MichaelSchmidl/Project5/hardware/CAD/BOM.xls

Part Name/Number | Description | Qty. | Comps. | Digikey | Netto | Summe
100K-1-0603 | Widerstand 100K 1% 0603 | 1 | R9 | 311-100KHRCT-ND | 0.08 | 0.10
100NF/50-X7R-0603 | Keramikkondensator 100nF/50V 0 | 9 | C1, C4-8, C10, C13, C15 | 1276-CL10B104KB8NNNLCT-ND | 0.08 | 0.86
100R-1-0603 | Widerstand 100R 1% 0603 | 1 | R2 | A129676CT-ND | 0.08 | 0.10
10NF/50-X7R-0603 | Keramikkondensator 10nF/50V 06 | 1 | C14 | 1276-1009-1-ND | 0.08 | 0.10
10R-1-0603 | Widerstand 10R 1% 0603 | 1 | R1 | YAG3351CT-ND | 0.08 | 0.10
10UF/16-X5R-0805 | Keramikkondensator 10uF/16V 08 | 2 | C2, C12 | 1276-6472-1-ND | 0.23 | 0.55
1UF/16-X5R-0805 | Keramikkondensator 1uF/16V 080 | 2 | C9, C11 | 1276-6471-1-ND | 0.08 | 0.19
22R-1-0603 | Widerstand 22R 1% 0603 | 4 | R11-14 | 311-22.0HRCT-ND | 0.08 | 0.38
2K2-1-0603 | Widerstand 2K2 1% 0603 | 2 | R8, R15 | 311-2.20KHRCT-ND | 0.08 | 0.19
74HC20-SO14 | 2 fach NAND mit 4 Eingängen | 1 | IC2 | 296-8263-1-ND | 0.27 | 0.32 | bestellen
AT42QT1011-SOT23-6 | Kapazitive Taste, single-key Q | 1 | IC3 | nicht vorrätig |  | 0
BCR108-SOT23 | NPN Digitaltransistor 50V/100 | 1 | T2 | BCR108E6327HTSA1CT-ND | 0.16 | 0.19
BLM21A-102S-0805 | Murata EMI Supression Filter ( | 1 | L1 | 490-1041-1-ND | 0.13 | 0.15
BLUETOOTH RSL10SIP | Bluetooth-Modul mit Antenne, 1 | 1 | A1 | NCH-RSL10-101S51-ACGOSCT-ND | 8.56 | 10.19
DMP2123L-SOT23 | P-Kanal MOSFET 20V/3A/72mR | 1 | T1 | DMP2123LDICT-ND | 0.35 | 0.42
IN-S124BRR LED R | Led rot, 1206, bottom view, 90 | 35 | H11-57 | 1830-1128-1-ND | 0.23 | 9.37 | bestellen
KP3216 LED 1206 OR | SMD-LED 1206 orange | 4 | H3-6 | 754-1140-1-ND | 0.26 | 1.24 | bestellen
MMA8652-DFN10 | Beschleunigungssensor, 3 Achse | 1 | B1 | vorhanden | 0.00 | 0.00
PCF8574-SO16 | I2C-Bus I/O-Expander | 1 | IC4 | 568-1076-5-ND | 1.07 | 1.27
REEDKONTAKT RI02-SMDM | Reedkontakt SMD 11,5x2,3mm | 1 | S1 | 1835-RI-02SMDM-1520-G1CT-ND | 0.55 | 0.65 | bestellen
TLC5955-QFN56 | 48 Kanal LED Treiber mit int P | 1 | IC1 | 296-40588-1-ND | 4.94 | 5.88
TSOP98636 LIEGEND | IR-Empfänger, 36kHz DeMod, RC5 | 1 | H1 | TSOP98636-ND | 0.85 | 1.01 | bestellen
_LEITERPLATTE-DEFAULT | Leiterplatte | 1 | LP1 | JLCPCB 61x53mm inkl. Versand |  | 7.68 | bestellen
Summe |  |  |  |  |  | 40.83
