MichaelSchmidl/Project5/hardware/CAD/EASTEREGG_100.stp

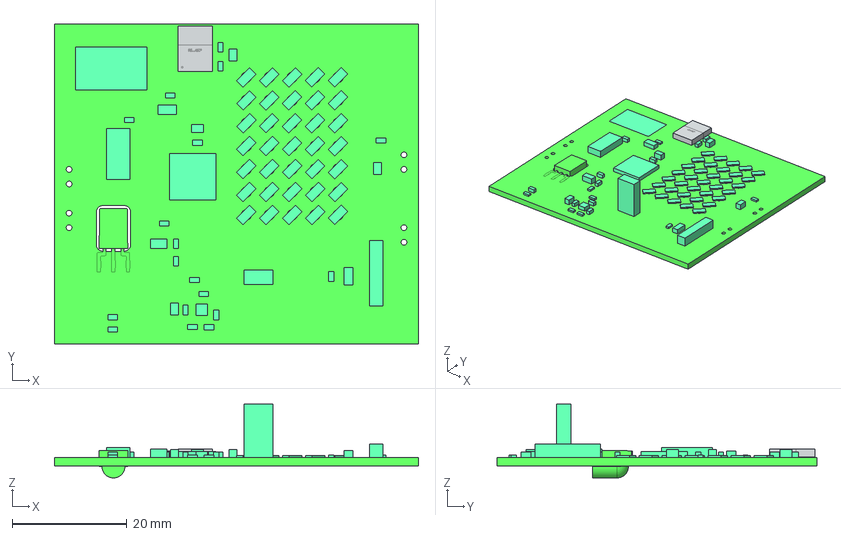
[picture p7: CAD file, 2021-01-31]
hardware/CAD/EASTEREGG_100.stp
63.5 x 55.9 x 12.9 mm
