MichaelSchmidl/Project5/hardware/CAD/Olli.stp

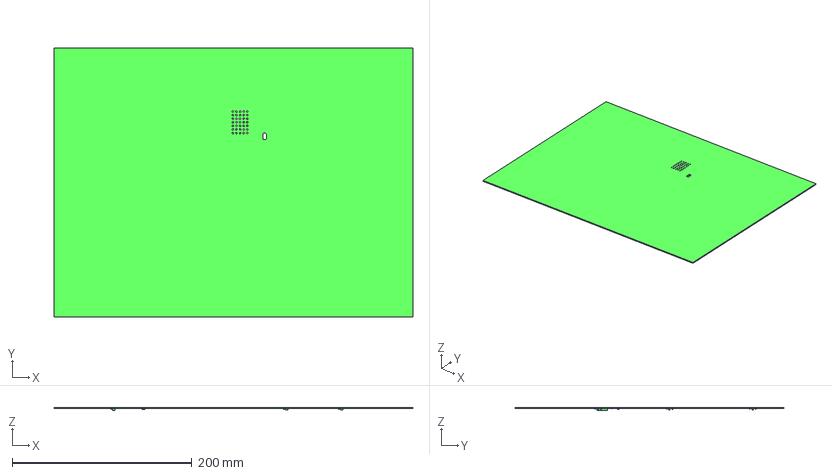
[picture p8: CAD file, 2021-01-31]
hardware/CAD/Olli.stp
400.0 x 300.0 x 3.80 mm
