MichaelSchmidl/Project5/hardware/CAD/EASTEREGG_SP_200.pdf

# Debug

# 5x7 LED Matrix

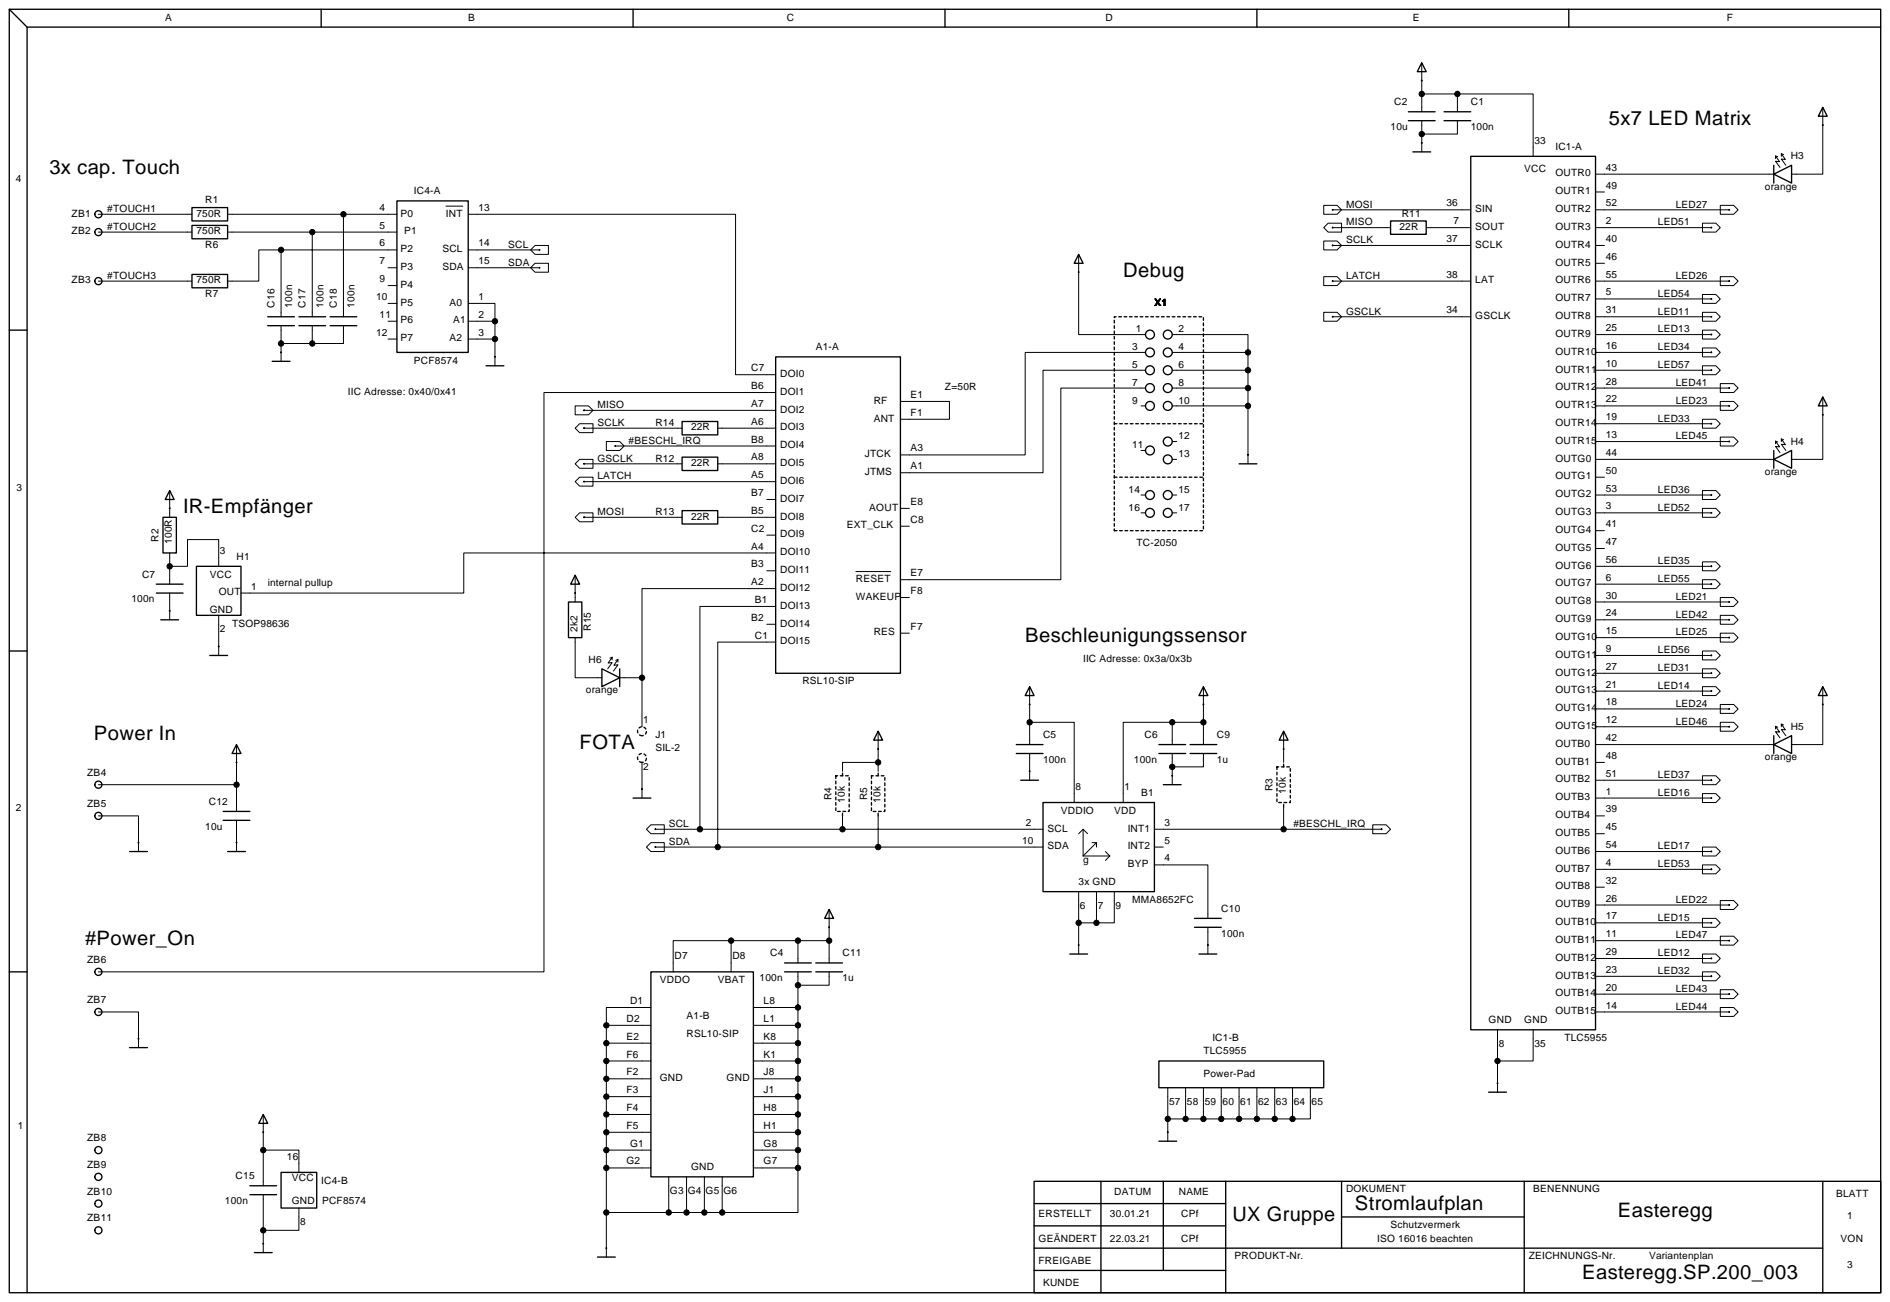
[picture p9: page 1]

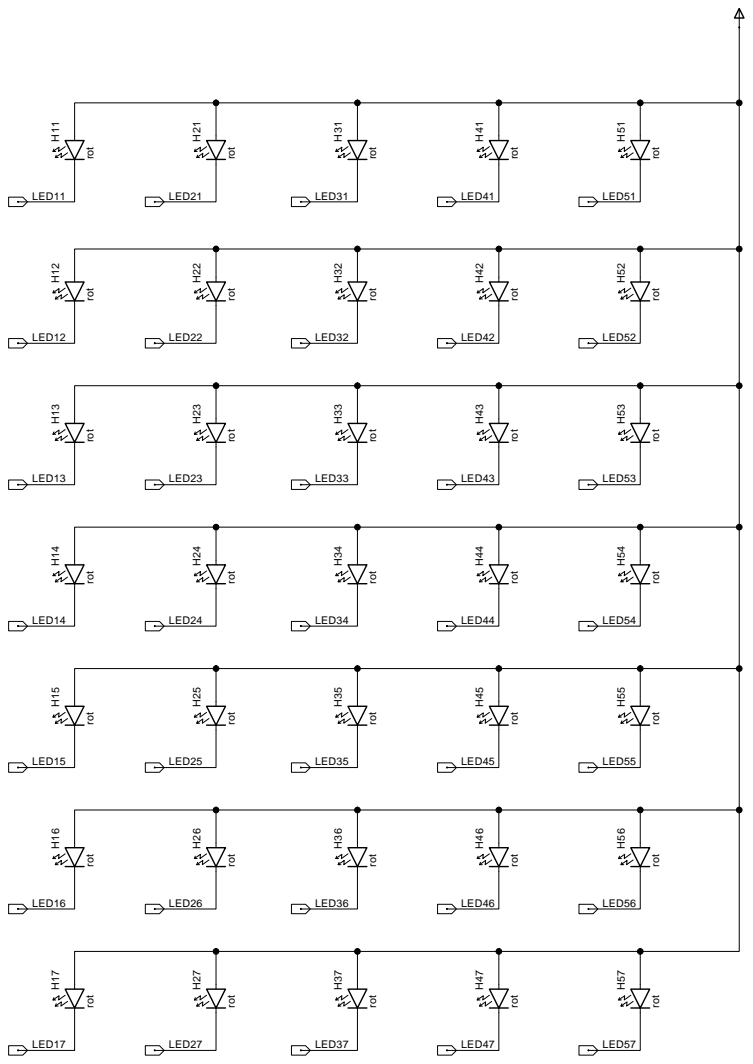
[picture p10: page 2]

# ÄNDERUNGS-HISTORIE

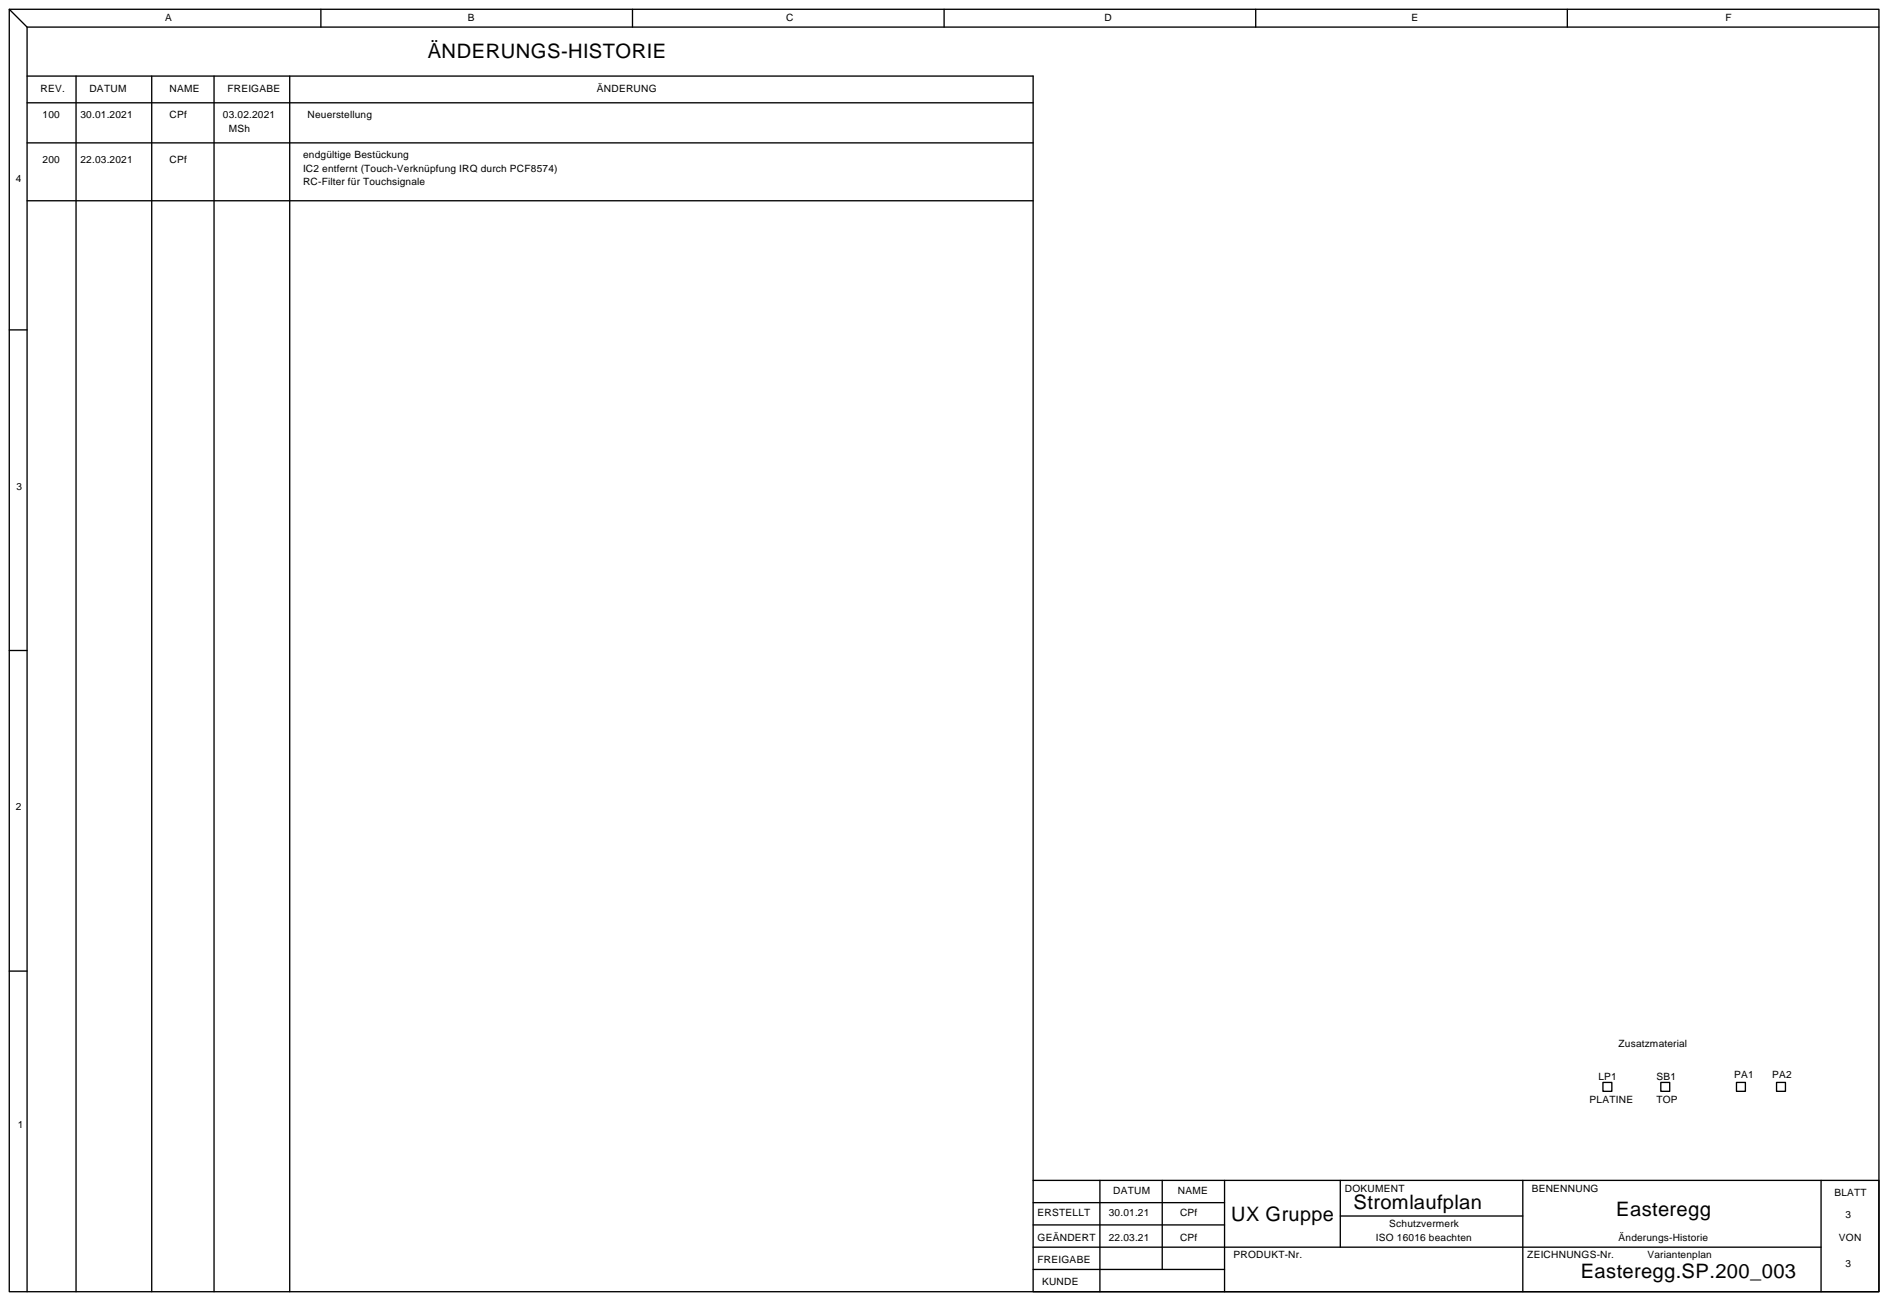
[picture p11: page 3]
BLATT; BENENNUNG; ERSTELLT; DATUM; NAME; DOKUMENT; UX Gruppe; Schutzvermerk; PLATINE; TOP; CPf; Stromlaufplan; Zusatzmaterial; FREIGABE; ÄNDERUNG; Änderungs-Historie; REV.; 03.02.2021 MSh; Easteregg; Neuerstellung

endgültige Bestückung
IC2 entfernt (Touch-Verknüpfung IRQ durch PCF8574)
RC-Filter für Touchsignale
