MichaelSchmidl/Project5/hardware/CAD/Olli_SP.pdf

# #Power_On

# Eingang von Batteriehalter

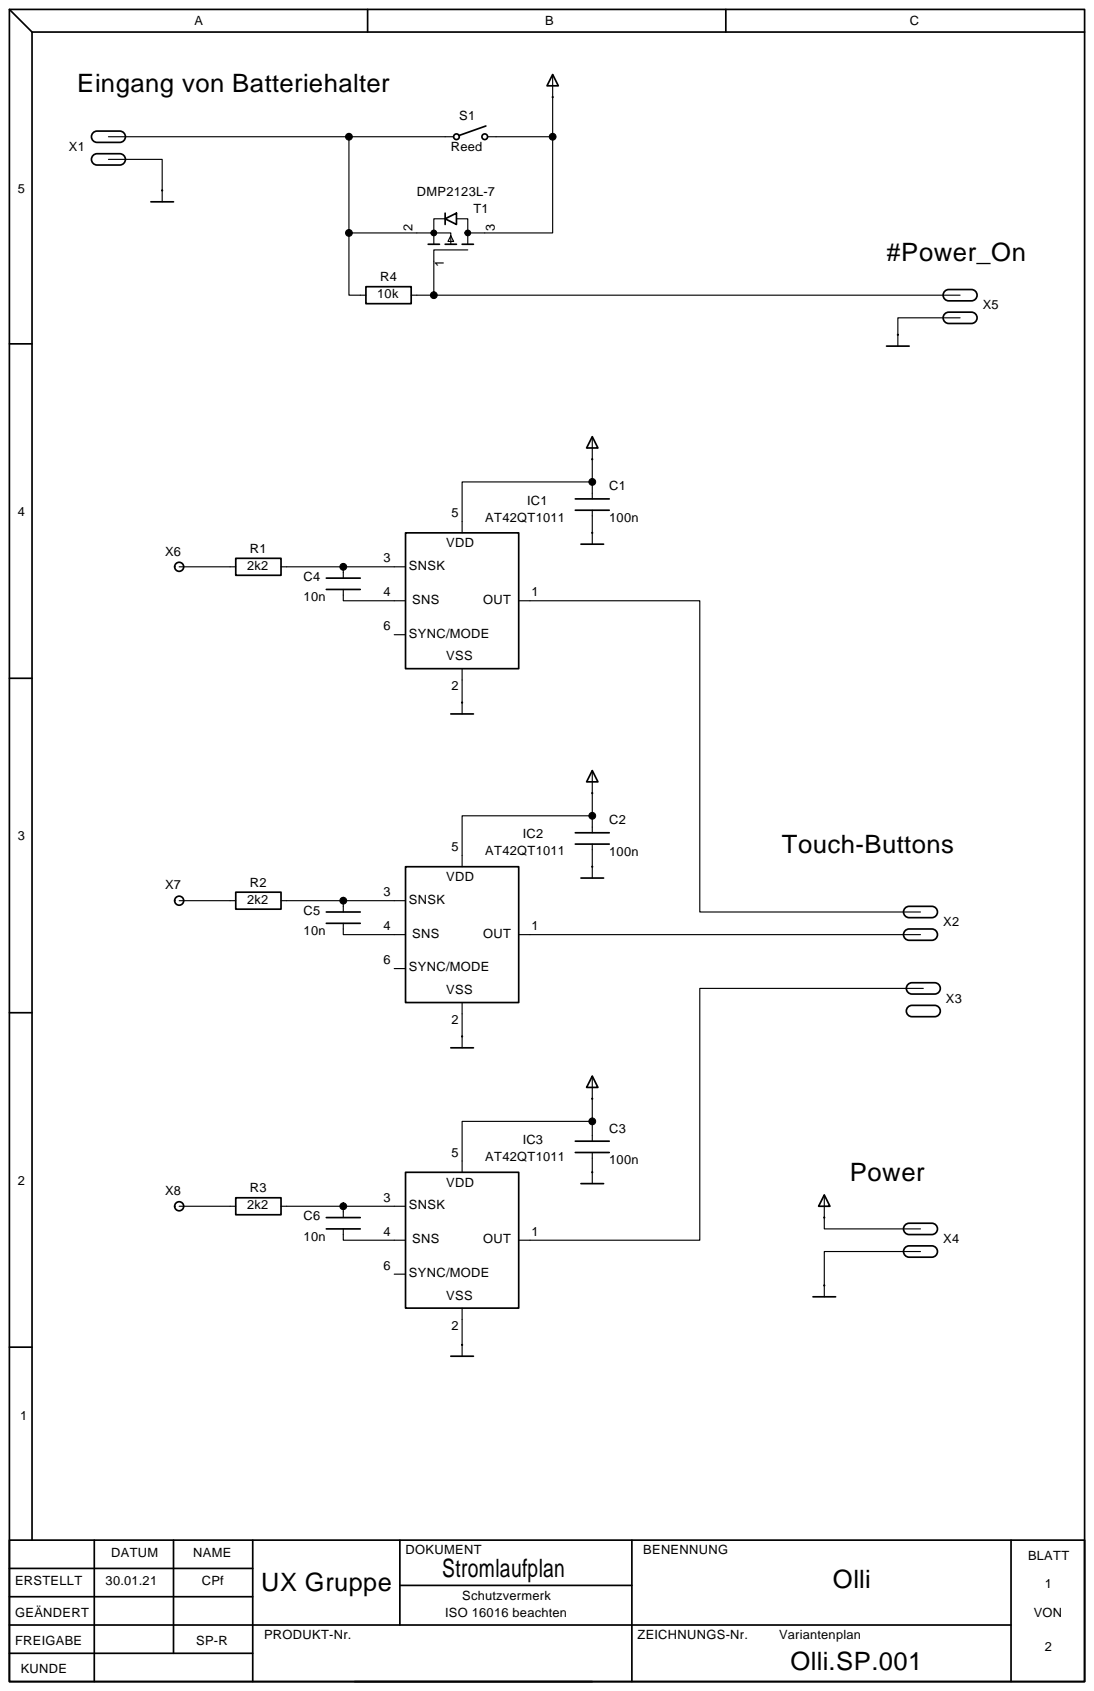
[picture p12: page 1]

# ÄNDERUNGS-HISTORIE

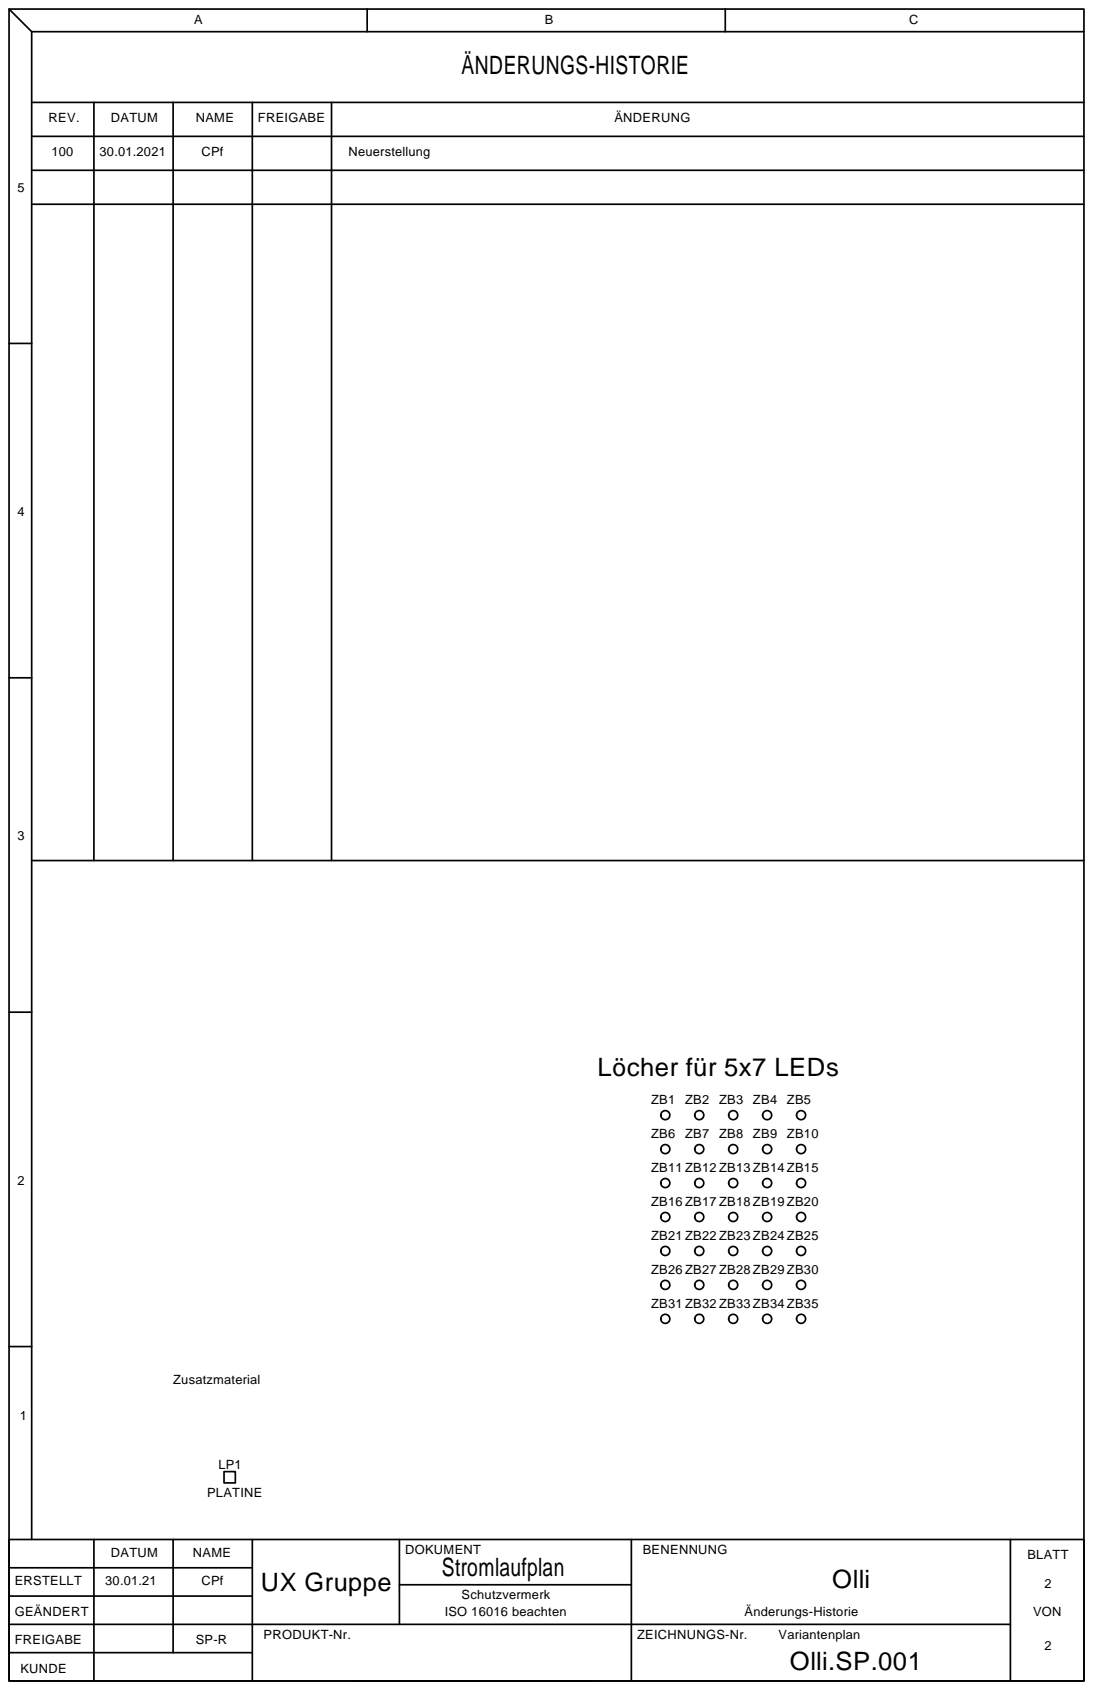
[picture p13: page 2]
VON; PRODUKT-Nr.; ZEICHNUNGS-Nr.; BLATT BENENNUNG; ISO 16016 beachten; ERSTELLT; FREIGABE; GEÄNDERT; KUNDE; DATUM; NAME; DOKUMENT; UX Gruppe; Schutzvermerk; PLATINE; ÄNDERUNG; Änderungs-Historie; REV.; Stromlaufplan; Neuerstellung; Zusatzmaterial; CPf; Olli; Olli.SP.001; Variantenplan

Löcher für 5x7 LEDs
