MichaelSchmidl/Project5/hardware/CAD/EASTEREGG_SP_100.pdf

# just for tuning

# 3x cap. Touch

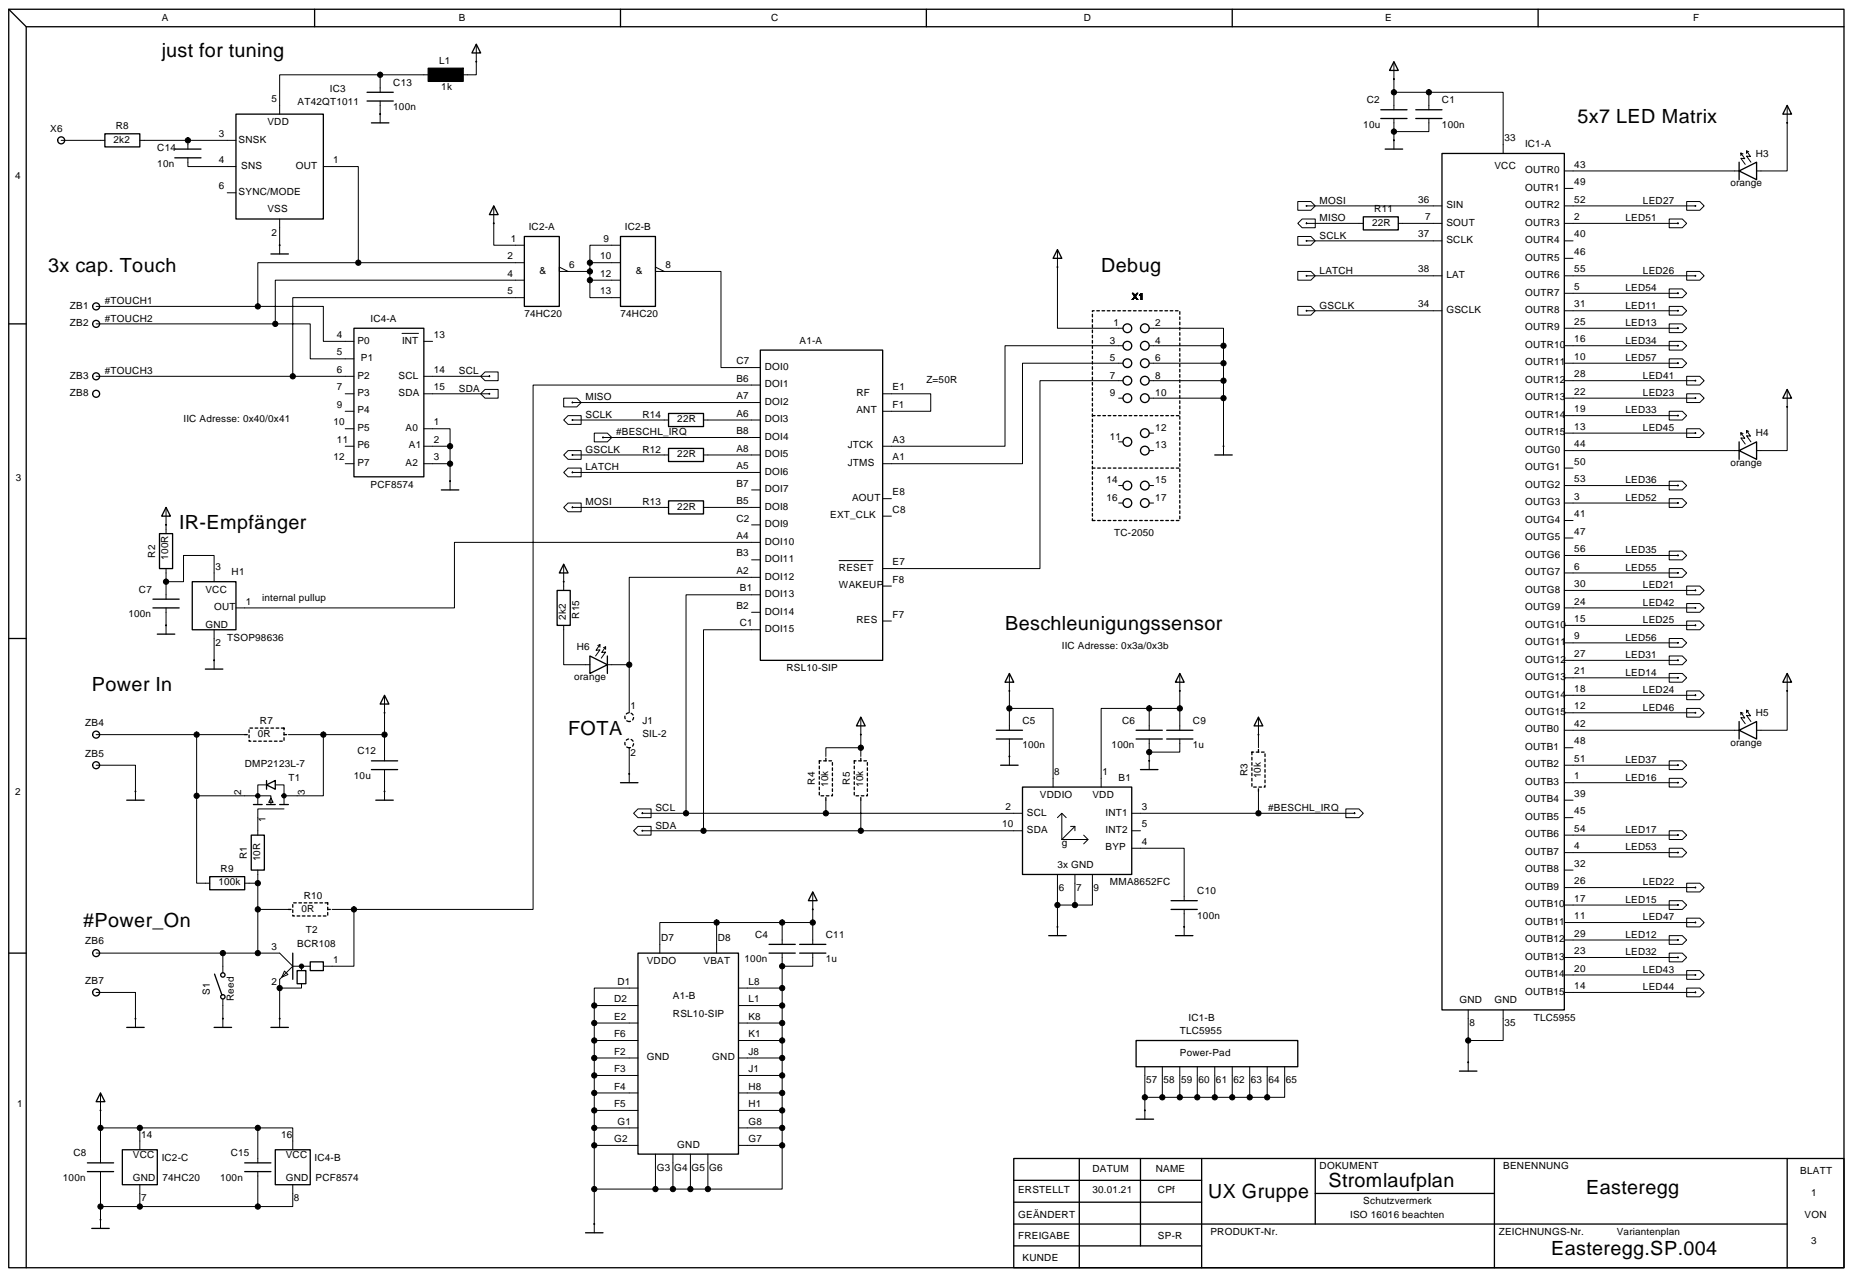
[picture p14: page 1]


# ÄNDERUNGS-HISTORIE

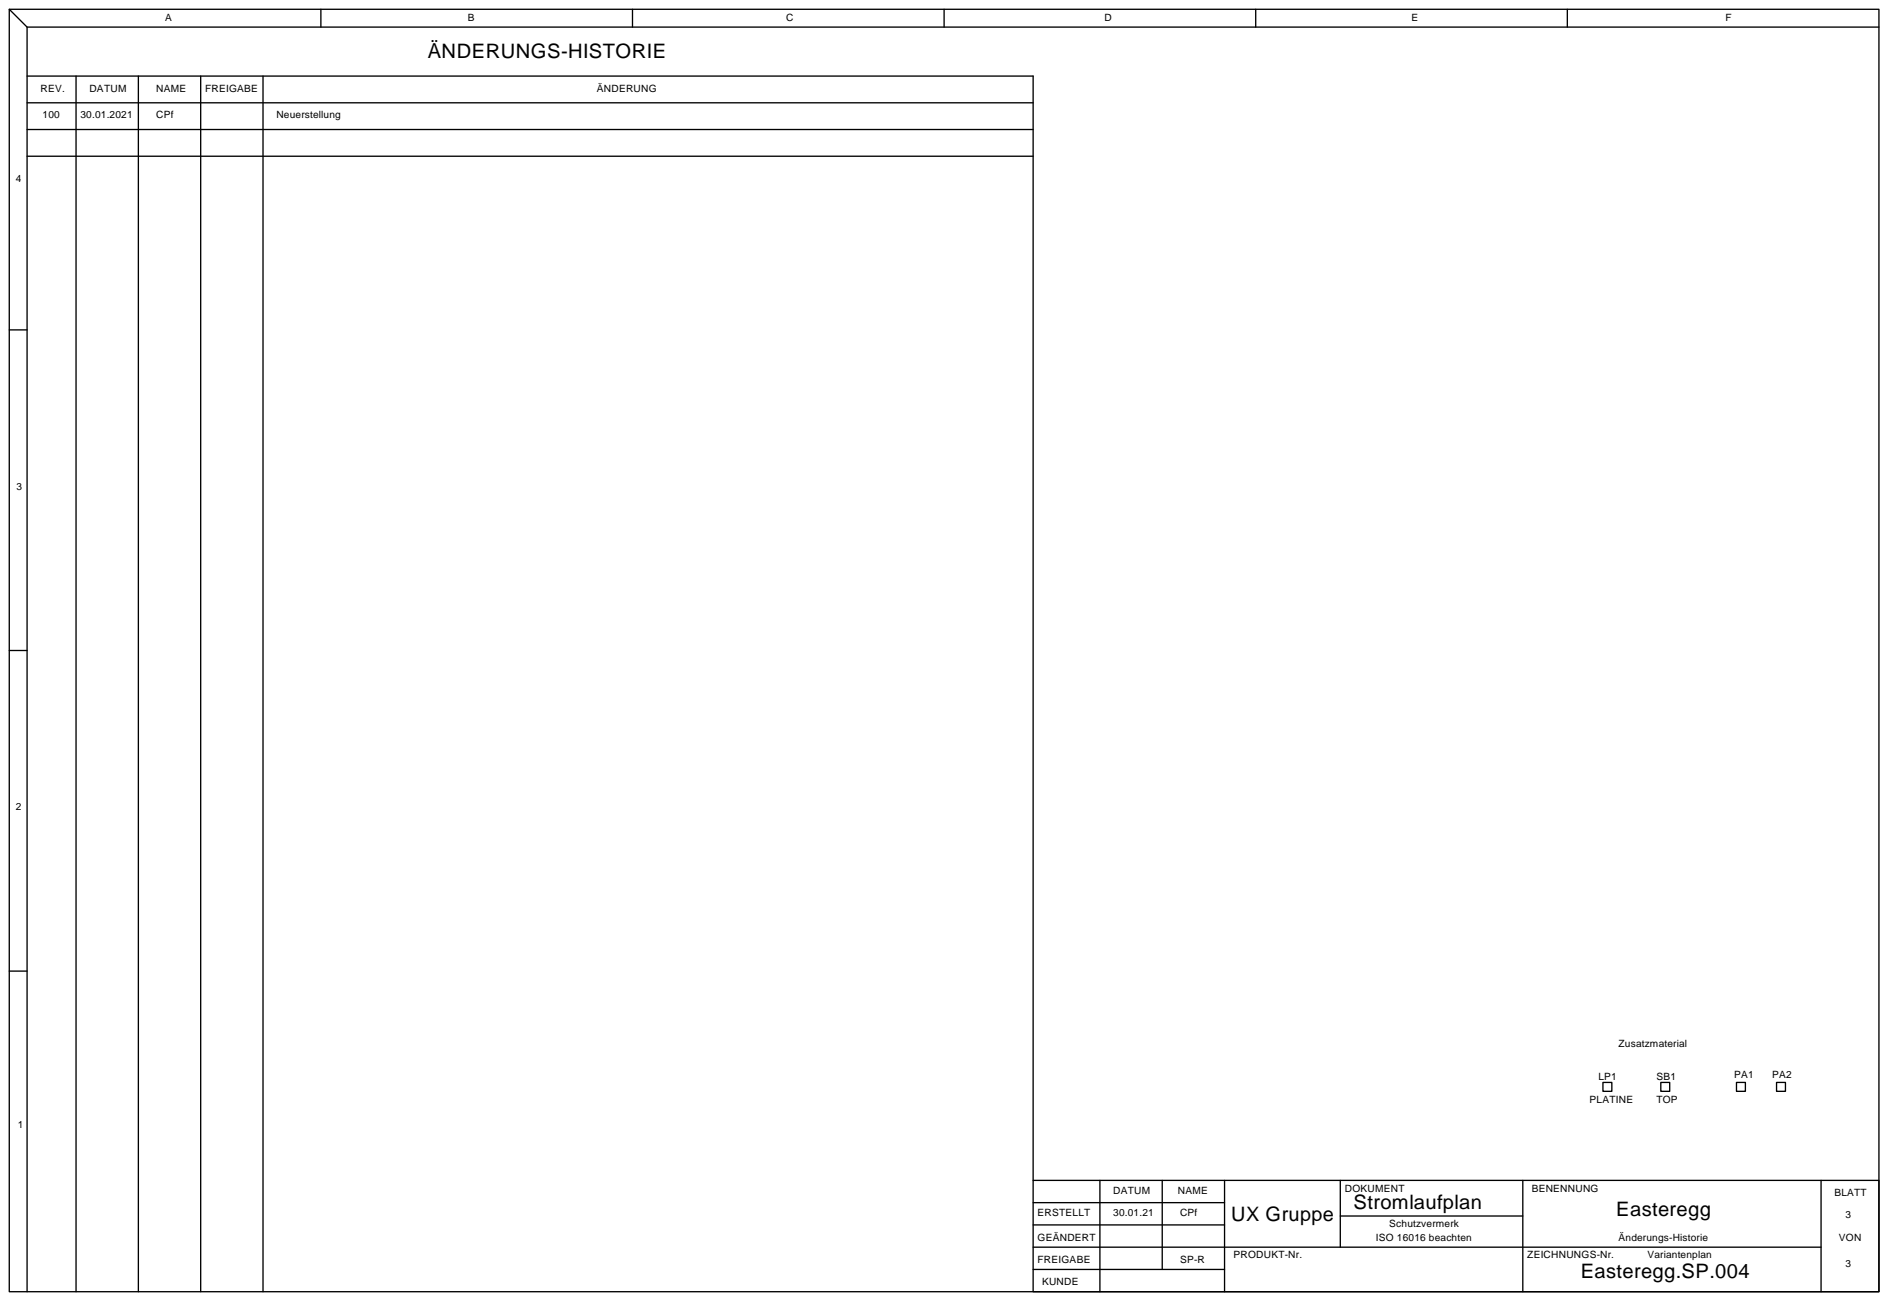
[picture p15: page 3]
BLATT; BENENNUNG; ERSTELLT; DATUM; NAME; DOKUMENT; UX Gruppe; Schutzvermerk; PLATINE; TOP; Neuerstellung; Stromlaufplan; Zusatzmaterial; ÄNDERUNG; Änderungs-Historie; REV.; FREIGABE; CPf; Easteregg
