MichaelSchmidl/Project5/docs/hw/EASTEREGG_BP_100.pdf

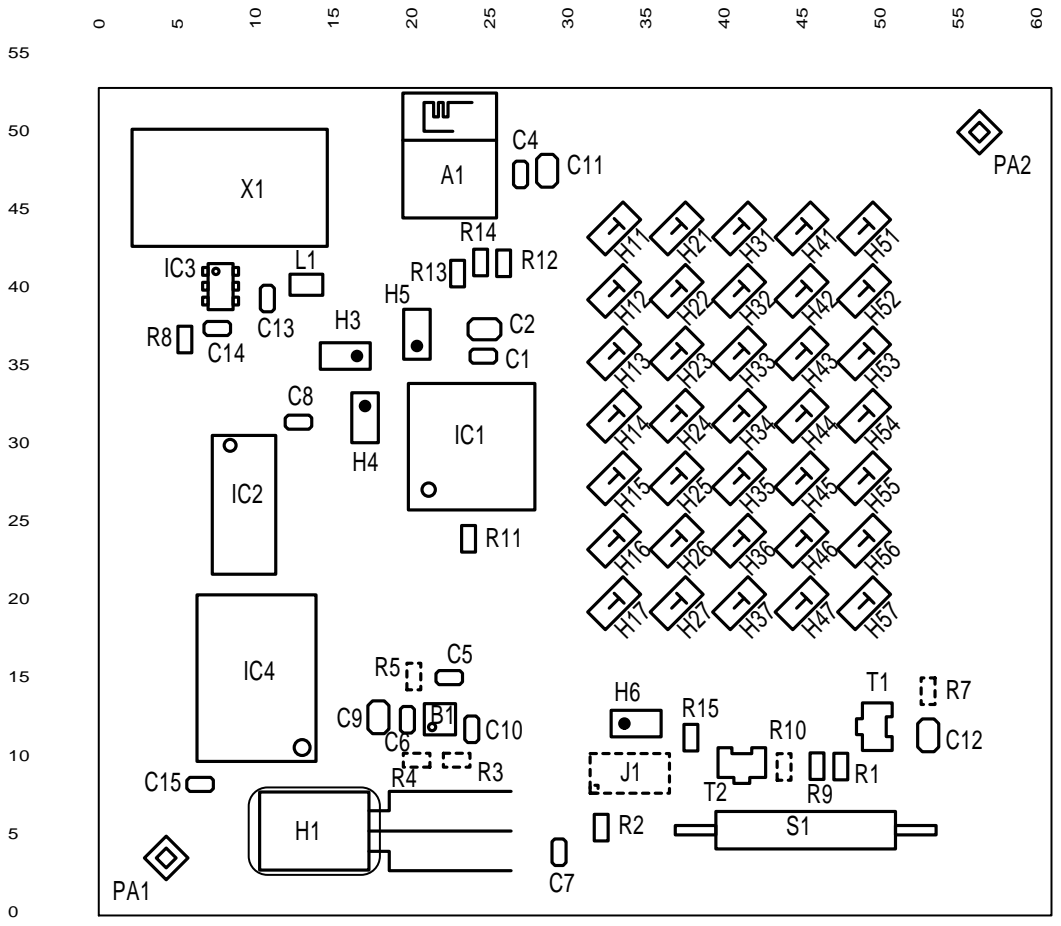
[picture p16: page 1]
