MichaelSchmidl/Project5/docs/hw/EASTEREGG_SP_100.pdf

# just for tuning

# 3x cap. Touch

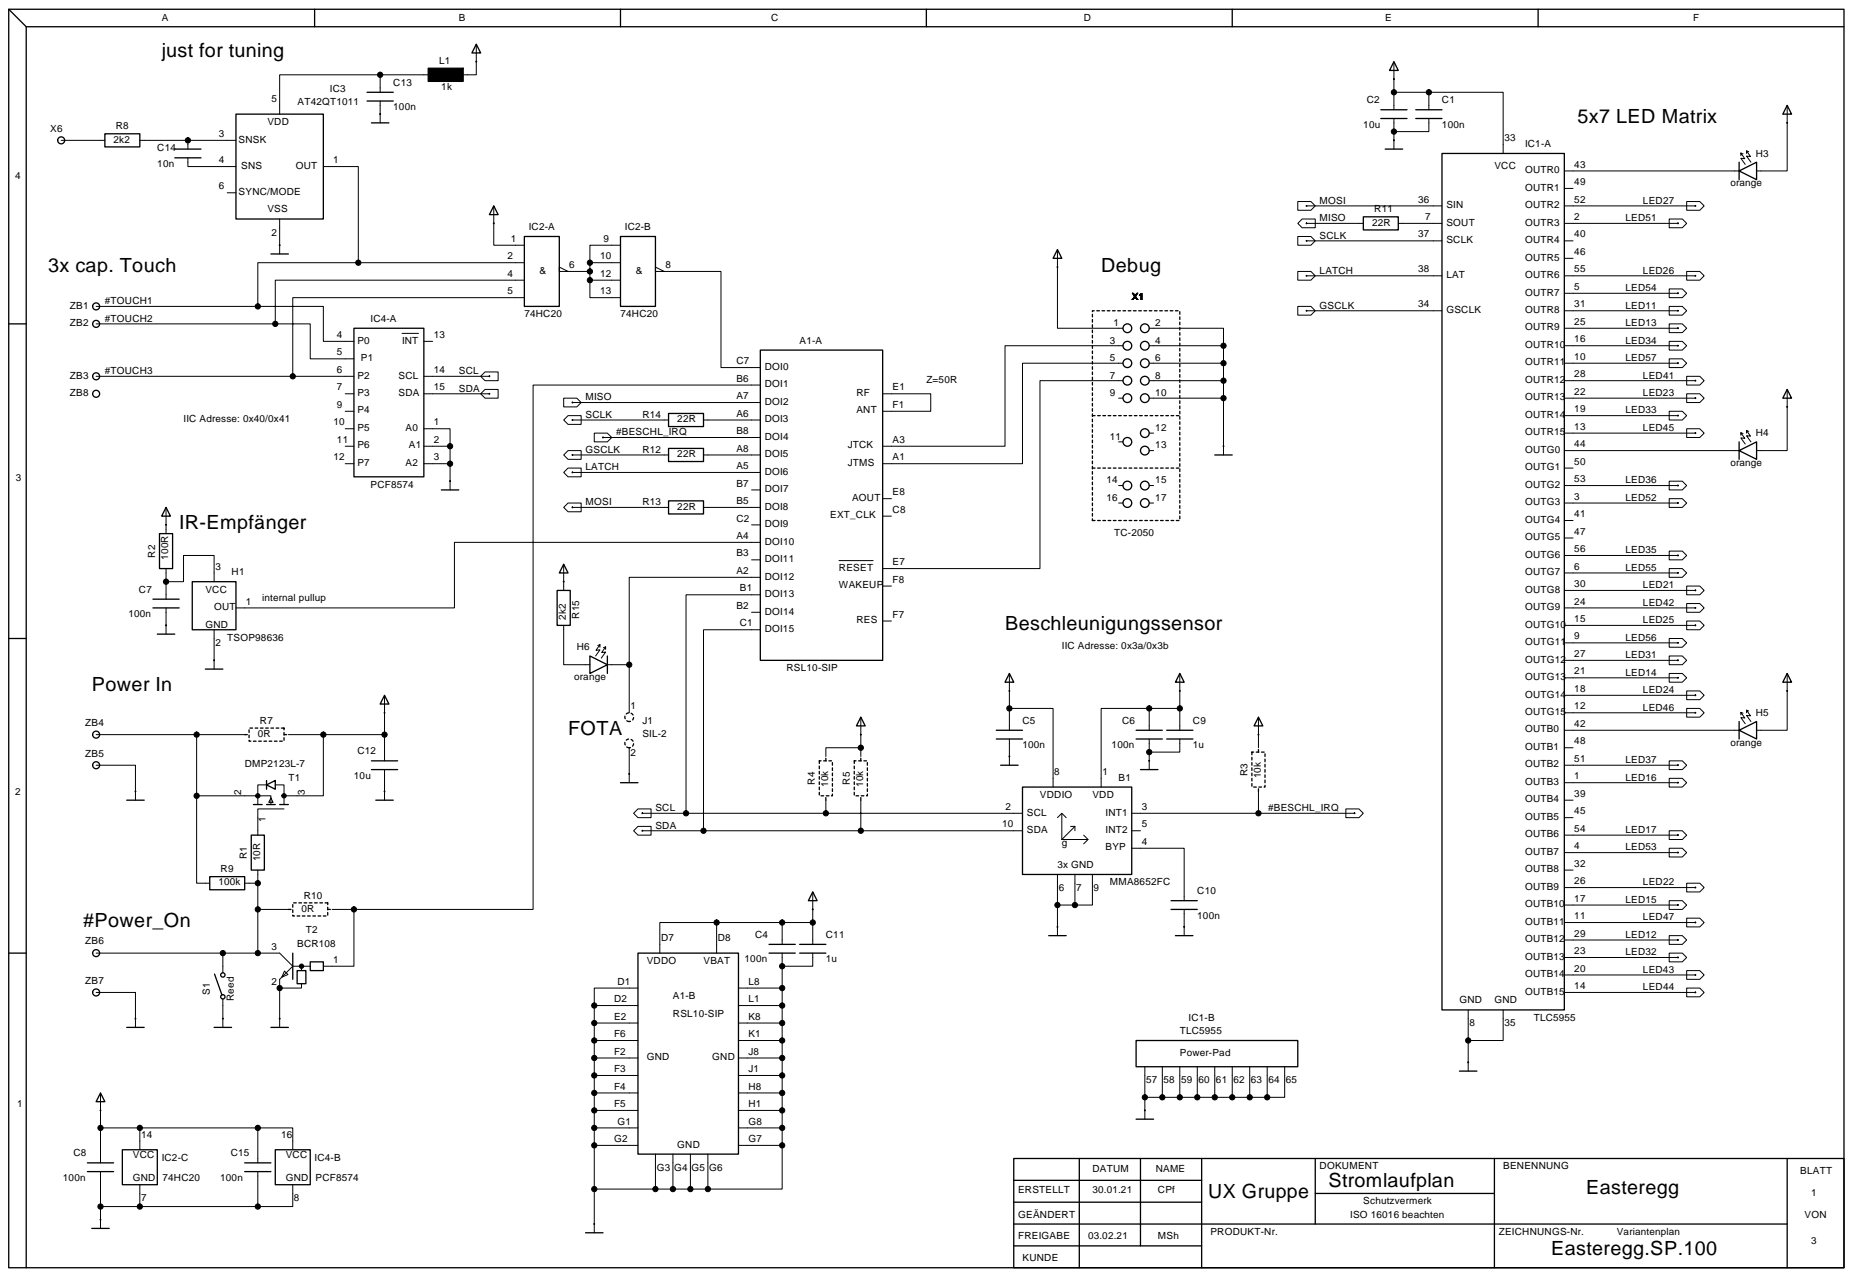
[picture p17: page 1]


# ÄNDERUNGS-HISTORIE

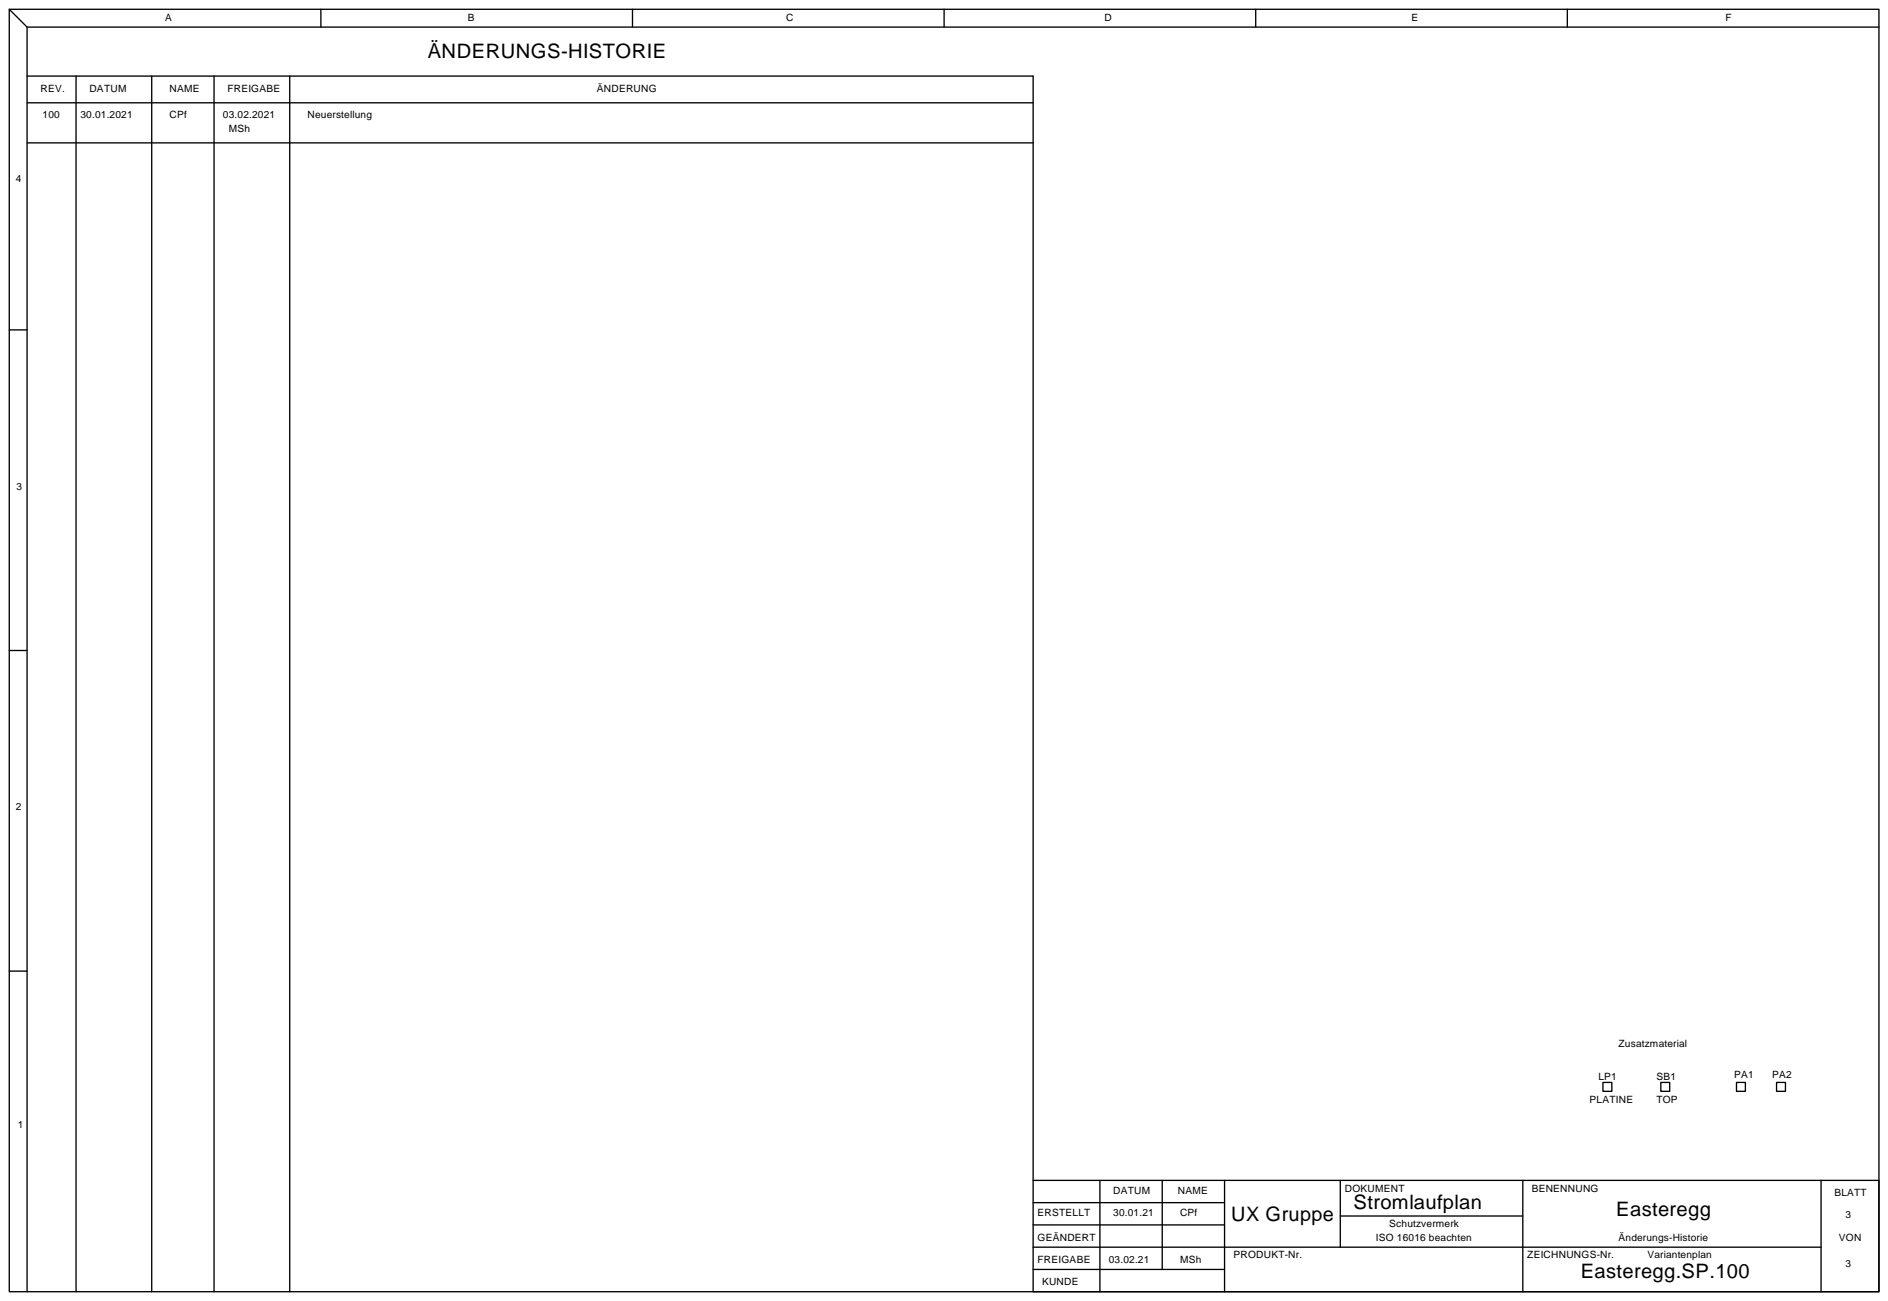
[picture p18: page 3]
BLATT; BENENNUNG; ERSTELLT; DATUM; NAME; DOKUMENT; UX Gruppe; Schutzvermerk; PLATINE; TOP; Stromlaufplan; Zusatzmaterial; FREIGABE; ÄNDERUNG; Änderungs-Historie; REV.; CPf; 03.02.2021 MSh; Easteregg; Neuerstellung
