MichaelSchmidl/Project5/docs/selbsthaltender REED/selbsthaltenderREED.asc

M1: pmos; Si4913DY
Q1: npn; 2N2222
R1: res; 1000; tol=1
R2: res; 100000; tol=1
R3: res; 10; tol=1
R4: res; 1000; tol=1
R5: res; 47000; tol=1
V1: battery; 3; Rser=0.1
V2: voltage; PULSE(0 3 1 0 0 1 2 50)
Named nets: 0, VBAT
.tran 10 startup
