MichaelSchmidl/Project5/(list of files, drawings)

Other design files:
hardware/CAD/EASTEREGG_100.pcb
hardware/CAD/EASTEREGG_200.pcb
