MichaelSchmidl/Project5/EasterEggApp/code/ble_std.c

/* ----------------------------------------------------------------------------
 * Copyright (c) 2015-2017 Semiconductor Components Industries, LLC (d/b/a
 * ON Semiconductor), All Rights Reserved
 *
 * Copyright (C) RivieraWaves 2009-2016
 *
 * This module is derived in part from example code provided by RivieraWaves
 * and as such the underlying code is the property of RivieraWaves [a member
 * of the CEVA, Inc. group of companies], together with additional code which
 * is the property of ON Semiconductor. The code (in whole or any part) may not
 * be redistributed in any form without prior written permission from
 * ON Semiconductor.
 *
 * The terms of use and warranty for this code are covered by contractual
 * agreements between ON Semiconductor and the licensee.
 *
 * This is Reusable Code.
 *
 * ----------------------------------------------------------------------------
 * ble_std.c
 * - Bluetooth standard functions and message handlers
 * ----------------------------------------------------------------------------
 * $Revision: 1.24 $
 * $Date: 2019/05/09 20:23:31 $
 * ------------------------------------------------------------------------- */

#include "app.h"

/* Bluetooth Environment Structures */
struct ble_env_tag ble_env[NUM_MASTERS];

/* List of functions used to create the database */
const appm_add_svc_func_t appm_add_svc_func_list[] = {
    SERVICE_ADD_FUNCTION_LIST, NULL
};

/* List of functions used to enable client services */
const appm_enable_svc_func_t appm_enable_svc_func_list[] = {
    SERVICE_ENABLE_FUNCTION_LIST, NULL
};

/* Bluetooth Device Address */
uint8_t bdaddr[BDADDR_LENGTH];
uint8_t bdaddr_type;

static struct gapm_set_dev_config_cmd *gapmConfigCmd;

/* ----------------------------------------------------------------------------
 * Function      : Device_Param_Prepare(struct app_device_param *param)
 * ----------------------------------------------------------------------------
 * Description   : Configure the device related stack parameters
 * Inputs       : - param    - Pointer to the parameters to be configured
 * Outputs       : None
 * Assumptions   : None
 * ------------------------------------------------------------------------- */
void Device_Param_Prepare(app_device_param_t *param)
{
    param->device_param_src_type = FLASH_PROVIDED_or_DFLT;

    if (param->device_param_src_type == APP_PROVIDED)
    {
        uint8_t temp_bleAddress[6] = APP_PUBLIC_BDADDR;
        uint8_t temp_irk[16] = APP_IRK;
        uint8_t temp_csrk[16] = APP_CSRK;
        uint8_t temp_privateKey[32] = APP_PRIVATE_KEY;
        uint8_t temp_publicKey_x[32] = APP_PUBLIC_KEY_X;
        uint8_t temp_publicKey_y[32] = APP_PUBLIC_KEY_Y;

        memcpy(param->bleAddress, temp_bleAddress, 6);
        memcpy(param->irk, temp_irk, 16);
        memcpy(param->csrk, temp_csrk, 16);
        memcpy(param->privateKey, temp_privateKey, 32);
        memcpy(param->publicKey_x, temp_publicKey_x, 32);
        memcpy(param->publicKey_y, temp_publicKey_y, 32);
    }
}

/* ----------------------------------------------------------------------------
 * Function      : signed int Find_Connected_Device_Index(uint8_t conidx)
 * ----------------------------------------------------------------------------
 * Description   : Return device index based on the connection index
 * Inputs        : - conidx         - connection index of the sending task
 *                                    instance
 * Outputs       : - a valid device index
 *                 - INVALID_DEV_IDX if not found
 * Assumptions   : None
 * ------------------------------------------------------------------------- */
signed int Find_Connected_Device_Index(uint8_t conidx)
{
    for (signed int i = 0; i < NUM_MASTERS; i++)
    {
        /* Check connection index to set device index */
        if (ble_env[i].state == APPM_CONNECTED && ble_env[i].conidx == conidx)
        {
            return (i);
        }
    }

    return (INVALID_DEV_IDX);
}

/* ----------------------------------------------------------------------------
 * Function      : uint8_t Connected_Peer_Num(void)
 * ----------------------------------------------------------------------------
 * Description   : Check how many peers are connected to this device
 * Inputs        : None
 * Outputs       : - The number of connected peers (between 0 and NUM_MASTERS)
 * Assumptions   : None
 * ------------------------------------------------------------------------- */
uint8_t Connected_Peer_Num(void)
{
    uint8_t count = 0;

    for (unsigned int i = 0; i < NUM_MASTERS; i++)
    {
        if (ble_env[i].state == APPM_CONNECTED)
        {
            count++;
        }
    }

    return (count);
}

/* ----------------------------------------------------------------------------
 * Standard Functions
 * ------------------------------------------------------------------------- */

/* ----------------------------------------------------------------------------
 * Function      : void BLE_Initialize(void)
 * ----------------------------------------------------------------------------
 * Description   : Initialize the BLE baseband and application manager
 * Inputs        : None
 * Outputs       : None
 * Assumptions   : None
 * ------------------------------------------------------------------------- */
void BLE_Initialize(void)
{
    struct gapm_reset_cmd *cmd;
    uint8_t default_addr[BDADDR_LENGTH] = PRIVATE_BDADDR;

    /* Seed the random number generator */
    srand(1);

    /* Set radio clock accuracy in ppm */
    BLE_DeviceParam_Set_ClockAccuracy(RADIO_CLOCK_ACCURACY);

    /* Initialize the kernel and Bluetooth stack */
    Kernel_Init(0);
    BLE_InitNoTL(0);

    /* Enable the Bluetooth related interrupts needed */
    NVIC_EnableIRQ(BLE_EVENT_IRQn);
    NVIC_EnableIRQ(BLE_RX_IRQn);
    NVIC_EnableIRQ(BLE_CRYPT_IRQn);
    NVIC_EnableIRQ(BLE_ERROR_IRQn);
    NVIC_EnableIRQ(BLE_SW_IRQn);
    NVIC_EnableIRQ(BLE_GROSSTGTIM_IRQn);
    NVIC_EnableIRQ(BLE_FINETGTIM_IRQn);
    NVIC_EnableIRQ(BLE_CSCNT_IRQn);
    NVIC_EnableIRQ(BLE_SLP_IRQn);

    /* Initialize task state for all peers */
    for (unsigned int i = 0; i < NUM_MASTERS; i++)
    {
        memset(&ble_env[i], 0, sizeof(ble_env[i]));
        ble_env[i].state = APPM_INIT;
    }

    /* Set Bluetooth device type and address: depending on the device address
     * type selected by the application, either a public or private address is
     * used:
     *     - In case public address type is selected: (i) If a public address is
     *       provided by the application, it is used; (ii) Otherwise the device
     *       public address available in DEVICE_INFO_BLUETOOTH_ADDR (located in
     *       NVR3) is used. If no public address is available in NVR3, a default
     *       public address pre-defined in the stack is used instead.
     *     - In case private address type is selected: the private address
     *       provided by the application is used. */
#if (BD_ADDRESS_TYPE == BD_TYPE_PUBLIC)
    bdaddr_type = GAPM_CFG_ADDR_PUBLIC;
    if (Device_Param_Read(PARAM_ID_PUBLIC_BLE_ADDRESS, (uint8_t *)&bdaddr))
    {
        memcpy(bdaddr, default_addr, sizeof(uint8_t) * BDADDR_LENGTH);
    }
    else
    {
        memcpy(bdaddr, &co_default_bdaddr, sizeof(uint8_t) * BDADDR_LENGTH);
    }
#else    /* if (BD_ADDRESS_TYPE == BD_TYPE_PUBLIC) */
    memcpy(bdaddr, default_addr, sizeof(uint8_t) * BDADDR_LENGTH);
    bdaddr_type = GAPM_CFG_ADDR_PRIVATE;
#endif    /* if (BD_ADDRESS_TYPE == BD_TYPE_PUBLIC) */

    /* Initialize GAPM configuration command to initialize the stack */
    gapmConfigCmd =
        malloc(sizeof(struct gapm_set_dev_config_cmd));
    gapmConfigCmd->operation      = GAPM_SET_DEV_CONFIG;
    gapmConfigCmd->role = GAP_ROLE_PERIPHERAL;
    memcpy(gapmConfigCmd->addr.addr, bdaddr, sizeof(uint8_t) * BDADDR_LENGTH);
    gapmConfigCmd->addr_type = bdaddr_type;
    gapmConfigCmd->renew_dur = RENEW_DUR;
    Device_Param_Read(PARAM_ID_IRK, (uint8_t *)&gapmConfigCmd->irk.key[0]);
    gapmConfigCmd->pairing_mode   = GAPM_PAIRING_SEC_CON |
                                    GAPM_PAIRING_LEGACY;
    gapmConfigCmd->gap_start_hdl  = 0;
    gapmConfigCmd->gatt_start_hdl = 0;
    gapmConfigCmd->max_mtu = MTU_MAX;
    gapmConfigCmd->max_mps = MPS_MAX;
    gapmConfigCmd->att_and_ext_cfg = ATT_CFG;
    gapmConfigCmd->sugg_max_tx_octets = TX_OCT_MAX;
    gapmConfigCmd->sugg_max_tx_time = TX_TIME_MAX;
    gapmConfigCmd->tx_pref_rates = GAP_RATE_ANY;
    gapmConfigCmd->rx_pref_rates = GAP_RATE_ANY;
    gapmConfigCmd->max_nb_lecb = 0x0;
    gapmConfigCmd->audio_cfg = 0;

    /* Reset the stack */
    cmd = KE_MSG_ALLOC(GAPM_RESET_CMD, TASK_GAPM, TASK_APP, gapm_reset_cmd);
    cmd->operation = GAPM_RESET;

    /* Send the message */
    ke_msg_send(cmd);
}

/* ----------------------------------------------------------------------------
 * Function      : bool Service_Add(void)
 * ----------------------------------------------------------------------------
 * Description   : Add the next service in the service list,
 *                 calling the appropriate add service function
 * Inputs        : None
 * Outputs       : return value - Indicates if any service has not yet been
 *                                added
 * Assumptions   : None
 * ------------------------------------------------------------------------- */
bool Service_Add(void)
{
    /* Check if another should be added in the database */
    if (appm_add_svc_func_list[ble_env[0].next_svc] != NULL)
    {
        /* Call the function used to add the required service */
        appm_add_svc_func_list[ble_env[0].next_svc] ();

        /* Select the next service to add */
        ble_env[0].next_svc++;
        return (true);
    }

    return (false);
}

/* ----------------------------------------------------------------------------
 * Function      : void Advertising_Start(void)
 * ----------------------------------------------------------------------------
 * Description   : Send a start advertising
 * Inputs        : None
 * Outputs       : None
 * Assumptions   : None
 * ------------------------------------------------------------------------- */
void Advertising_Start(void)
{
    uint8_t device_name_length;
    uint8_t device_name_avail_space;
    uint8_t scan_rsp[SCAN_RSP_DATA_LEN] = APP_SCNRSP_DATA;
    uint8_t company_id[APP_COMPANY_ID_DATA_LEN] = APP_COMPANY_ID_DATA;

    /* Change state to advertising */
    for (unsigned int i = 0; i < NUM_MASTERS; i++)
    {
        if (ble_env[i].state == APPM_READY)
        {
            ble_env[i].state = APPM_ADVERTISING;
        }
    }

    /* Prepare the GAPM_START_ADVERTISE_CMD message */
    struct gapm_start_advertise_cmd *cmd;

    /* Prepare the start advertisement command message */
    cmd = KE_MSG_ALLOC(GAPM_START_ADVERTISE_CMD, TASK_GAPM, TASK_APP,
                       gapm_start_advertise_cmd);
    cmd->op.addr_src = GAPM_STATIC_ADDR;
    cmd->channel_map = APP_ADV_CHMAP;

    cmd->intv_min = APP_ADV_INT_MIN;
    cmd->intv_max = APP_ADV_INT_MAX;

    cmd->op.code = GAPM_ADV_UNDIRECT;
    cmd->op.state = 0;
    cmd->info.host.mode = GAP_GEN_DISCOVERABLE;
    cmd->info.host.adv_filt_policy = 0;

    /* Set the scan response data */
    cmd->info.host.scan_rsp_data_len = APP_SCNRSP_DATA_LEN;
    memcpy(&cmd->info.host.scan_rsp_data[0],
           scan_rsp, cmd->info.host.scan_rsp_data_len);

    /* Get remaining space in the advertising data -
     * 2 bytes are used for name length/flag */
    cmd->info.host.adv_data_len = 0;
    device_name_avail_space = (ADV_DATA_LEN - 3) - 2;

    /* Check if data can be added to the advertising data */
    if (device_name_avail_space > 0)
    {
        /* Add as much of the device name as possible */
        device_name_length = strlen(APP_DFLT_DEVICE_NAME);
        if (device_name_length > 0)
        {
            /* Check available space */
            device_name_length = co_min(device_name_length,
                                        device_name_avail_space);
            cmd->info.host.adv_data[cmd->info.host.adv_data_len] =
                device_name_length + 1;

            /* Fill device name flag */
            cmd->info.host.adv_data[cmd->info.host.adv_data_len + 1] =
                APP_DEVICE_NAME_FLAG;

            /* Copy device name */
            memcpy(&cmd->info.host.adv_data[cmd->info.host.adv_data_len + 2],
                   APP_DFLT_DEVICE_NAME, device_name_length);

            /* Update advertising data length */
            cmd->info.host.adv_data_len += (device_name_length + 2);
        }

        /* If there is still space, add the company ID */
        if (((ADV_DATA_LEN - 3) - cmd->info.host.adv_data_len - 2) >=
            APP_COMPANY_ID_DATA_LEN)
        {
            memcpy(&cmd->info.host.adv_data[cmd->info.host.adv_data_len],
                   company_id, APP_COMPANY_ID_DATA_LEN);
            cmd->info.host.adv_data_len += APP_COMPANY_ID_DATA_LEN;
        }
    }

    /* Send the message */
    ke_msg_send(cmd);
}

/* ----------------------------------------------------------------------------
 * Standard Message Handlers
 * ------------------------------------------------------------------------- */
/* ----------------------------------------------------------------------------
 * Function      : int GAPM_ProfileAddedInd(ke_msg_id_t const msg_id,
 *                                          struct gapm_profile_added_ind
 *                                          const *param,
 *                                          ke_task_id_t const dest_id,
 *                                          ke_task_id_t const src_id)
 * ----------------------------------------------------------------------------
 * Description   : Handle the received result of adding a profile to the
 *                 attribute database
 * Inputs        : - msg_id     - Kernel message ID number
 *                 - param      - Message parameters in format of
 *                                struct gapm_profile_added_ind
 *                 - dest_id    - Destination task ID number
 *                 - src_id     - Source task ID number
 * Outputs       : return value - Indicate if the message was consumed;
 *                                compare with KE_MSG_CONSUMED
 * Assumptions   : None
 * ------------------------------------------------------------------------- */
int GAPM_ProfileAddedInd(ke_msg_id_t const msg_id,
                         struct gapm_profile_added_ind const *param,
                         ke_task_id_t const dest_id,
                         ke_task_id_t const src_id)
{
    /* If the application is creating its attribute database, continue to add
     * services; otherwise do nothing. */
    if (ble_env[0].state == APPM_CREATE_DB)
    {
        /* Add the next requested service */
        if (!Service_Add())
        {
            for (unsigned int i = 0; i < NUM_MASTERS; i++)
            {
                /* If there are no more services to add, go to the ready state */
                ble_env[i].state = APPM_READY;
            }

            /* No more services to add, start advertising */
            Advertising_Start();
        }
    }

    return (KE_MSG_CONSUMED);
}

/* ----------------------------------------------------------------------------
 * Function      : int GAPM_CmpEvt(ke_msg_id_t const msg_id,
 *                                 struct gapm_cmp_evt const *param,
 *                                 ke_task_id_t const dest_id,
 *                                 ke_task_id_t const src_id)
 * ----------------------------------------------------------------------------
 * Description   : Handle the reception of a GAPM complete event
 * Inputs        : - msg_id     - Kernel message ID number
 *                 - param      - Message parameters in format of
 *                                struct gapm_cmp_evt
 *                 - dest_id    - Destination task ID number
 *                 - src_id     - Source task ID number
 * Outputs       : return value - Indicate if the message was consumed;
 *                                compare with KE_MSG_CONSUMED
 * Assumptions   : None
 * ------------------------------------------------------------------------- */
int GAPM_CmpEvt(ke_msg_id_t const msg_id,
                struct gapm_cmp_evt const *param,
                ke_task_id_t const dest_id,
                ke_task_id_t const src_id)
{
    struct gapm_set_dev_config_cmd *cmd;

    switch (param->operation)
    {
        /* A reset has occurred, configure the device and
         * start a kernel timer for the application */
        case (GAPM_RESET):
        {
            if (param->status == GAP_ERR_NO_ERROR)
            {
                /* Set the device configuration */
                cmd = KE_MSG_ALLOC(GAPM_SET_DEV_CONFIG_CMD, TASK_GAPM, TASK_APP,
                                   gapm_set_dev_config_cmd);
                memcpy(cmd, gapmConfigCmd,
                       sizeof(struct gapm_set_dev_config_cmd));
                free(gapmConfigCmd);

                /* Send message */
                ke_msg_send(cmd);

                /* Start a timer to be used as a periodic tick timer for
                 * application */
                ke_timer_set(APP_TEST_TIMER, TASK_APP, TIMER_200MS_SETTING);

                /* Start LED timer */
                ke_timer_set(LED_TIMER, TASK_APP, TIMER_200MS_SETTING);

            	// start the 100ms YAKINDU timer tick - keine Ahnung warum das nur hier funktioniert
                ke_timer_set(YAKINDU_TIMER, TASK_APP, TIMER_YAKINDU_SETTING);
}
        }
        break;

        /* Device configuration updated */
        case (GAPM_SET_DEV_CONFIG):
        {
            /* Start creating the GATT database */
            ble_env[0].state = APPM_CREATE_DB;

            /* Add the first required service in the database */
            if (!Service_Add())
            {
                for (unsigned int i = 0; i < NUM_MASTERS; i++)
                {
                    /* If there are no more services to add, go to the ready
                     * state */
                    ble_env[i].state = APPM_READY;
                }

                /* Start advertising since there are no services to add
                 * to the attribute database */
                Advertising_Start();
            }
        }
        break;

        case (GAPM_RESOLV_ADDR):
        {
            /* Address could not be resolved by any IRK. Send connection
             * confirmation without keys. */
            if (param->status == GAP_ERR_NOT_FOUND)
            {
                uint8_t device_indx = KE_IDX_GET(dest_id);
                Send_Connection_Confirmation(device_indx);
                BLE_SetServiceState(true, device_indx);
            }
        }
        break;

        default:
        {
            /* No action required for other operations */
        }
        break;
    }

    return (KE_MSG_CONSUMED);
}

/* ----------------------------------------------------------------------------
 * Function      : int GAPC_GetDevInfoReqInd(ke_msg_id_t const msg_id,
 *                                           struct gapc_get_dev_info_req_ind
 *                                           const *param,
 *                                           ke_task_id_t const dest_id,
 *                                           ke_task_id_t const src_id)
 * ----------------------------------------------------------------------------
 * Description   : Handle message device info request received from GAP
 *                 controller
 * Inputs        : - msg_id     - Kernel message ID number
 *                 - param      - Message parameters in format of
 *                                struct gapc_get_dev_info_req_ind
 *                 - dest_id    - Destination task ID number
 *                 - src_id     - Source task ID number
 * Outputs       : return value - Indicate if the message was consumed;
 *                                compare with KE_MSG_CONSUMED
 * Assumptions   : None
 * ------------------------------------------------------------------------- */
int GAPC_GetDevInfoReqInd(ke_msg_id_t const msg_id,
                          struct gapc_get_dev_info_req_ind const *param,
                          ke_task_id_t const dest_id,
                          ke_task_id_t const src_id)
{
    uint8_t len = strlen(APP_DFLT_DEVICE_NAME);

    /* Allocate message */
    struct gapc_get_dev_info_cfm *cfm = KE_MSG_ALLOC_DYN(GAPC_GET_DEV_INFO_CFM,
                                                         src_id, dest_id,
                                                         gapc_get_dev_info_cfm,
                                                         len);

    switch (param->req)
    {
        case GAPC_DEV_NAME:
        {
            cfm->req = GAPC_DEV_NAME;
            memcpy(&cfm->info.name.value[0], APP_DFLT_DEVICE_NAME, len);
            cfm->info.name.length = len;
        }
        break;

        case GAPC_DEV_APPEARANCE:
        {
            /* Set the device appearance (no appearance) */
            cfm->info.appearance = 0;
            cfm->req = GAPC_DEV_APPEARANCE;
            cfm->info.appearance = GAPM_WRITE_DISABLE;
        }
        break;

        case GAPC_DEV_SLV_PREF_PARAMS:
        {
            /* Slave preferred connection interval (minimum) */
            cfm->info.slv_params.con_intv_min = PREF_SLV_MIN_CON_INTERVAL;

            /* Slave preferred connection interval (maximum) */
            cfm->info.slv_params.con_intv_max = PREF_SLV_MAX_CON_INTERVAL;

            /* Slave preferred connection latency */
            cfm->info.slv_params.slave_latency = PREF_SLV_LATENCY;

            /* Slave preferred link supervision timeout */
            cfm->info.slv_params.conn_timeout = PREF_SLV_SUP_TIMEOUT;

            cfm->req = GAPC_DEV_SLV_PREF_PARAMS;
        }
        break;

        default:
        {
            /* No action required for other requests */
        }
        break;
    }

    /* Send message */
    ke_msg_send(cfm);

    return (KE_MSG_CONSUMED);
}

/* ----------------------------------------------------------------------------
 * Function      : int GAPC_ConnectionReqInd(ke_msg_idd_t const msg_id,
 *                                           struct gapc_connection_req_ind
 *                                           const *param,
 *                                           ke_task_id_t const dest_id,
 *                                           ke_task_id_t const src_id)
 * ----------------------------------------------------------------------------
 * Description   : Handle connection indication message received from GAP
 *                 controller
 * Inputs        : - msg_id     - Kernel message ID number
 *                 - param      - Message parameters in format of
 *                                struct gapc_connection_req_ind
 *                 - dest_id    - Destination task ID number
 *                 - src_id     - Source task ID number
 * Outputs       : return value - Indicate if the message was consumed;
 *                                compare with KE_MSG_CONSUMED
 * Assumptions   : None
 * ------------------------------------------------------------------------- */
int GAPC_ConnectionReqInd(ke_msg_id_t const msg_id,
                          struct gapc_connection_req_ind const *param,
                          ke_task_id_t const dest_id,
                          ke_task_id_t const src_id)
{
    if (Connected_Peer_Num() < NUM_MASTERS)
    {
        uint8_t device_indx;

        /* Search for the first disconnected link */
        for (device_indx = 0; device_indx < NUM_MASTERS; device_indx++)
        {
            if (ble_env[device_indx].state != APPM_CONNECTED)
            {
                break;
            }
        }

        /* Set connection index */
        ble_env[device_indx].conidx = KE_IDX_GET(src_id);

        /* Check if the received connection handle was valid */
        if (ble_env[device_indx].conidx != GAP_INVALID_CONIDX)
        {
            /* Change peer state in the app environment structure */
            ble_env[device_indx].state = APPM_CONNECTED;

            /* Retrieve the connection info from the parameters */
            ble_env[device_indx].conhdl = param->conhdl;

            /* Copy peer address */
            memcpy(ble_env[device_indx].bond_info.ADDR, param->peer_addr.addr,
                   sizeof(param->peer_addr.addr));
            ble_env[device_indx].bond_info.ADDR_TYPE = param->peer_addr_type;

            /* Initialize bond info state */
            ble_env[device_indx].bond_info.STATE = BOND_INFO_STATE_EMPTY;

            /* If address is private resolvable, resolve it */
            if ((param->peer_addr_type == BD_TYPE_PRIVATE) &&
                ((param->peer_addr.addr[5] & 0xc0) == 0x40))
            {
                struct gap_sec_key irkList[APP_BONDLIST_SIZE];
                uint8_t numKeys = BondList_GetIRKs(irkList);

                if (numKeys > 0)
                {
                    struct gapm_resolv_addr_cmd *resolveAddr = KE_MSG_ALLOC_DYN(
                        GAPM_RESOLV_ADDR_CMD, TASK_GAPM,
                        KE_BUILD_ID(TASK_APP, device_indx),
                        gapm_resolv_addr_cmd,
                        sizeof(struct gap_sec_key) * numKeys);

                    resolveAddr->operation = GAPM_RESOLV_ADDR;
                    resolveAddr->nb_key = numKeys;
                    memcpy(&resolveAddr->addr, param->peer_addr.addr,
                           sizeof(bd_addr_t));
                    memcpy(resolveAddr->irk, irkList,
                           sizeof(struct gap_sec_key) * numKeys);

                    /* Request stack to resolve address given the IRK list */
                    ke_msg_send(resolveAddr);

                    /* Return here because we need to wait for
                     * GAPM_AddrSolvedInd or GAPM_CmpEvt before sending a
                     * connection confirmation*/
                    return (KE_MSG_CONSUMED);
                }
            }
            /* If not private resolvable, try to find/load bond info from flash.
             * If found, ble_env[device_indx].bond_info.STATE will be loaded
             * with a valid value and Send_Connection_Confirmation will include
             * the LTK */
            else
            {
                BondList_FindByAddr(param->peer_addr.addr,
                                    param->peer_addr_type,
                                    &ble_env[device_indx].bond_info);
            }

            Send_Connection_Confirmation(device_indx);
            BLE_SetServiceState(true, device_indx);
        }
    }

    return (KE_MSG_CONSUMED);
}

/* ----------------------------------------------------------------------------
 * Function      : int GAPC_CmpEvt(ke_msg_id_t const msg_id,
 *                                 struct gapc_cmp_evt const *param,
 *                                 ke_task_id_t const dest_id,
 *                                 ke_task_id_t const src_id)
 * ----------------------------------------------------------------------------
 * Description   : Handle received GAPC complete event
 * Inputs        : - msg_id     - Kernel message ID number
 *                 - param      - Message parameters in format of
 *                                struct gapc_cmp_evt
 *                 - dest_id    - Destination task ID number
 *                 - src_id     - Source task ID number
 * Outputs       : return value - Indicate if the message was consumed;
 *                                compare with KE_MSG_CONSUMED
 * Assumptions   : None
 * ------------------------------------------------------------------------- */
int GAPC_CmpEvt(ke_msg_id_t const msg_id,
                struct gapc_cmp_evt const *param,
                ke_task_id_t const dest_id,
                ke_task_id_t const src_id)
{
    /* No operations in this application use this event */
    return (KE_MSG_CONSUMED);
}

/* ----------------------------------------------------------------------------
 * Function      : int GAPC_DisconnectInd(ke_msg_id_t const msg_id,
 *                                        struct gapc_disconnect_ind
 *                                        const *param,
 *                                        ke_task_id_t const dest_id,
 *                                        ke_task_id_t const src_id)
 * ----------------------------------------------------------------------------
 * Description   : Handle disconnect indication message from GAP controller
 * Inputs        : - msg_id     - Kernel message ID number
 *                 - param      - Message parameters in format of
 *                                struct gapc_disconnect_ind
 *                 - dest_id    - Destination task ID number
 *                 - src_id     - Source task ID number
 * Outputs       : return value - Indicate if the message was consumed;
 *                                compare with KE_MSG_CONSUMED
 * Assumptions   : None
 * ------------------------------------------------------------------------- */
int GAPC_DisconnectInd(ke_msg_id_t const msg_id,
                       struct gapc_disconnect_ind const *param,
                       ke_task_id_t const dest_id,
                       ke_task_id_t const src_id)
{
    /* Retrieve the index of environment structure representing peer device */
    signed int device_indx = Find_Connected_Device_Index(KE_IDX_GET(src_id));

    if (device_indx == INVALID_DEV_IDX)
    {
        return (KE_MSG_CONSUMED);
    }

    /* Empty the CSRK and IRK fields in case the next device does not
     * send these fields */
    memset(ble_env[device_indx].bond_info.IRK, 0,
           (sizeof(ble_env[device_indx].bond_info.IRK)));
    memset(ble_env[device_indx].bond_info.CSRK, 0,
           (sizeof(ble_env[device_indx].bond_info.CSRK)));

    /* Go to the ready state */
    ble_env[device_indx].state = APPM_READY;

    /* Disable services for this connection */
    BLE_SetServiceState(false, device_indx);

    return (KE_MSG_CONSUMED);
}

/* ----------------------------------------------------------------------------
 * Function      : int GAPC_ParamUpdatedInd(ke_msg_id_t const msg_id,
 *                                          struct gapc_param_updated_ind
 *                                          const *param,
 *                                          ke_task_id_t const dest_id,
 *                                          ke_task_id_t const src_id)
 * ----------------------------------------------------------------------------
 * Description   : Handle message parameter updated indication received from
 *                 GAP controller
 * Inputs        : - msg_id     - Kernel message ID number
 *                 - param      - Message parameters in format of
 *                                struct gapc_param_updated_ind
 *                 - dest_id    - Destination task ID number
 *                 - src_id     - Source task ID number
 * Outputs       : return value - Indicate if the message was consumed;
 *                                compare with KE_MSG_CONSUMED
 * Assumptions   : None
 * ------------------------------------------------------------------------- */
int GAPC_ParamUpdatedInd(ke_msg_id_t const msg_id,
                         struct gapc_param_updated_ind const *param,
                         ke_task_id_t const dest_id,
                         ke_task_id_t const src_id)
{
    /* Retrieve the index of environment structure representing peer device */
    signed int device_indx = Find_Connected_Device_Index(KE_IDX_GET(src_id));

    if (device_indx == INVALID_DEV_IDX)
    {
        return (KE_MSG_CONSUMED);
    }

    ble_env[device_indx].updated_con_interval = param->con_interval;
    ble_env[device_indx].updated_latency = param->con_latency;
    ble_env[device_indx].updated_suo_to = param->sup_to;

    return (KE_MSG_CONSUMED);
}

/* ----------------------------------------------------------------------------
 * Function      : int GAPC_ParamUpdateReqInd(ke_msg_id_t const msg_id,
 *                         struct gapc_param_update_req_ind const *param,
 *                         ke_task_id_t const dest_id,
 *                         ke_task_id_t const src_id)
 * ----------------------------------------------------------------------------
 * Description   :
 * ------------------------------------------------------------------------- */
int GAPC_ParamUpdateReqInd(ke_msg_id_t const msg_id,
                           struct gapc_param_update_req_ind const *param,
                           ke_task_id_t const dest_id,
                           ke_task_id_t const src_id)
{
    struct gapc_param_update_cfm *cfm;

    /* Retrieve the index of environment structure representing peer device */
    signed int device_indx = Find_Connected_Device_Index(KE_IDX_GET(src_id));

    if (device_indx == INVALID_DEV_IDX)
    {
        return (KE_MSG_CONSUMED);
    }

    cfm = KE_MSG_ALLOC(GAPC_PARAM_UPDATE_CFM,
                       KE_BUILD_ID(TASK_GAPC, ble_env[device_indx].conidx),
                       KE_BUILD_ID(TASK_APP, device_indx),
                       gapc_param_update_cfm);
    cfm->accept = 1;
    cfm->ce_len_max = 0xFFFF;
    cfm->ce_len_min = 0xFFFF;

    /* Send message */
    ke_msg_send(cfm);

    return (KE_MSG_CONSUMED);
}

/* ----------------------------------------------------------------------------
 * Function      : void BLE_SetServiceState(bool enable, uint8_t device_indx)
 * ----------------------------------------------------------------------------
 * Description   : Set Bluetooth application environment state to enabled
 * Inputs        : - enable      - Indicates that enable request should be sent
 *                                 for all services/profiles or their status
 *                                 should be set to enabled or disabled
 *                 - device_indx - Peer device index in the app env structure
 * Outputs       : None
 * Assumptions   : Peer device must be connected. This function should
 *                  only be called after ConnectionConfirmation is sent.
 * ------------------------------------------------------------------------- */
void BLE_SetServiceState(bool enable, uint8_t device_indx)
{
    if (device_indx != INVALID_DEV_IDX)
    {
        /* All standard services should be send enable request to the stack,
         * for custom services, application should decide if it would want
         * to do a specific action
         * all services should be disabled once the link is lost
         */
        if (enable == true)
        {
            /* To enable standard Bluetooth services, an enable request should
             * be sent to the stack (for related profile) and at receiving the
             * response the enable flag can be set. For custom service it is
             * application implementation dependent. Here, it starts service
             * discovery, and if the service UUID and characteristics UUID are
             * discovered, then it goes to an state that is equivalent to the
             * enable flag of standard profiles
             */
            ble_env[device_indx].next_svc_enable = 0;
            Service_Enable(ble_env[device_indx].conidx);
        }
        else
        {
            bass_support_env[device_indx].enable = false;
        }
    }

    /* Keep advertising while all masters are not connected */
    if (Connected_Peer_Num() < NUM_MASTERS)
    {
        Advertising_Start();
    }
}

/* ----------------------------------------------------------------------------
 * Function      : bool Service_Enable(uint8_t conidx)
 * ----------------------------------------------------------------------------
 * Description   : Enable the next service in the service list,
 *                 calling the appropriate enable service function
 * Inputs        : - conidx     - Connection index
 * Outputs       : return value - Indicates if any service has not yet been
 *                                added
 * Assumptions   : None
 * ------------------------------------------------------------------------- */
bool Service_Enable(uint8_t conidx)
{
    /* Retrieve the index of environment structure representing peer device */
    signed int device_indx = Find_Connected_Device_Index(conidx);

    if (device_indx == INVALID_DEV_IDX)
    {
        return (false);
    }

    /* Check if another should be added in the database */
    if (appm_enable_svc_func_list[ble_env[device_indx].next_svc_enable] != NULL)
    {
        /* Call the function used to enable the required service */
        appm_enable_svc_func_list[ble_env[device_indx].next_svc_enable] (conidx);

        /* Select the next service to enable */
        ble_env[device_indx].next_svc_enable++;
        return (true);
    }

    return (false);
}

/* ----------------------------------------------------------------------------
 * Function      : void Send_Connection_Confirmation(uint8_t device_indx)
 * ----------------------------------------------------------------------------
 * Description   : Send connection confirmation to peer device
 * Inputs        : - device_indx - Peer device index in the app env structure
 * Outputs       : None
 * Assumptions   : None
 * ------------------------------------------------------------------------- */
void Send_Connection_Confirmation(uint8_t device_indx)
{
    struct gapc_connection_cfm *cfm;

    /* Allocate connection confirmation message */
    cfm = KE_MSG_ALLOC(GAPC_CONNECTION_CFM,
                       KE_BUILD_ID(TASK_GAPC, ble_env[device_indx].conidx),
                       KE_BUILD_ID(TASK_APP, device_indx), gapc_connection_cfm);

    if (VALID_BOND_INFO(ble_env[device_indx].bond_info.STATE))
    {
        cfm->ltk_present = true;
        Device_Param_Read(PARAM_ID_CSRK, (uint8_t *)&cfm->lcsrk);
        memset(&cfm->lsign_counter, 0xff, 4);
        memcpy(&cfm->rcsrk, &ble_env[device_indx].bond_info.CSRK, KEY_LEN);
        memset(&cfm->rsign_counter, 0, 4);
    }
    else
    {
        cfm->ltk_present = false;
    }

    cfm->svc_changed_ind_enable = 0;
    cfm->pairing_lvl = GAP_AUTH_REQ_NO_MITM_BOND;

    /* Send the message */
    ke_msg_send(cfm);
}
