MichaelSchmidl/Project5/EasterEggApp/include/CompBraille.h

/*
 * CompBraille.h
 *
 *  Created on: 27.01.2021
 *      Author: mschmidl
 */

#ifndef INCLUDE_COMPBRAILLE_H_
#define INCLUDE_COMPBRAILLE_H_

/*!************************************************************************************************************************************************************
 *
 *************************************************************************************************************************************************************/
#include "CompLeds.h"


void compBraille_renderGlyph( char c );
void compBraille_showText( char *pszText );
void compBraille_showChar( char c );


#endif /* INCLUDE_COMPBRAILLE_H_ */
