MichaelSchmidl/Project5/EasterEggApp/include/CompMorse.h

/*
 * CompMorse.h
 *
 *  Created on: 07.03.2021
 *      Author: mschmidl
 */

#ifndef INCLUDE_COMPMORSE_H_
#define INCLUDE_COMPMORSE_H_

#include "CompLeds.h"


void compMorse_showText( char *pszText );
void compMorse_showChar( char c );


#endif /* INCLUDE_COMPMORSE_H_ */
