MichaelSchmidl/Project5/(commit log)

2021-01-14 0.0.4: using the RSL_GPIO function to get an interrupt from the GPIO pin
2021-01-18 RC5 Empfang funktioniert über Timer0. Allerdings funktioniert das "resyncing" nicht wie ich das gedacht habe. Daher jetzt erstmal mit "fester" Abtastung nach Start
2021-01-19 started with PWM and SPI driver - not working so far
    [RC5receiver.c, RC5receiver.h, TLC5955drv.c, TLC5955drv.h, app.c, app.h, app_init.c]
2021-01-21 DIO13, 14 und 15 können nun normal verwendet werden. GSCLK mit 8MHz über CLKOUT - keine PWM mehr
2021-01-21 SPI liefert auch Signale wie gewünscht.
2021-01-22 TLC5955 driver von E54 portiert. Sieht am SALEAE gut aus. Muss mal eine BORA P02 testweise anschliessen
2021-01-23 double-buffering f. SPI Transfer MOSI Daten
2021-01-26 nachdem FreeRTOS und FOTA scheinbar aus Speichergründen nicht geht, fang ich nun mal mit einer Businesslogik auf die einfache Art an. Ich hänge mich dazu in den 200ms APP_TIMER rein und treibe damit 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
2021-01-31 erste Schaltplanteile
    [EASTEREGG.stp, Olli.stp]
2021-01-31 002 des Schaltplans
2021-02-01 FreeRTOS eingebaut. FOTA kann nun nur noch direkt nach dem Einschalten über Taste erreicht werden - nicht mehr zur Laufzeit. Das komplette DRAM mit 72KByte wird nun der App zugeschlagen. DRAM_DSP rau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
2021-02-01 so, erste Dinge laufen. Man muss erstmal durch den ganzen String und dann LOEWE PLAY senden per RC5. Dann wird per SPI ein Frame ausgegeben auf dem TLC5955.
    Bislang geht das mit FreeRTOS gut. Allerdings verstehe ich die KEY_STATE Logik immer noch nicht.
2021-02-02 Layout 003
    [EASTEREGG.pcb]
2021-02-02 RTT funktioniert, Multi-Function FOTA-DEBUG-LED Pin ebenfalls. ACHTUNG: unbedingt den RTT VIEWER nicht auf AUTO laufen lassen
    [BOM.xls]
2021-02-02 puh, die Businesslogik wird heftig. Jetzt hab ich schon mal eine Möglichkeit "Strings" automatisch zu schicken
2021-02-03 004 Hardware
    [BOM.xls, EASTEREGG.pcb]
2021-02-06 mit YAKINDU erzeugte Statemachine integriert. Nach BLE connected ist, toggelt die Statemachine jede Sekunde die DIO6 LED.
2021-02-07 GYRO doku hinzugefügt und Relikt aus Struct entfernt
2021-02-07 Bild der Statemachine wird nun automatisch mit erzeugt
2021-02-09 so, die Statemachine wird schon. Den Greeting Text kann ich damit schon jede Minute verschicken. Die ersten beiden Touches sollten auch gehen. Ich weiß nur nicht, wie ich die drei Touches am Ende in 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
2021-02-15 Statemachine erweitert. URL Teile senden wird nun nicht in der Statemachine sondern in Code abgewickelt.
2021-02-15 Skripte zum initialen Programmieren des Bootloaders und der FOTA Lib. Damit kann man den initialen Schritt des Downloads per UART überspringen
2021-03-01 Schalt- u. Bestückungsplan der Rev100 Platine
2021-03-03 DEBUG LED korrigiert, Firmware stürzt aber trotzdem noch ab nach einer Minute
    [EASTEREGG.pcb, EASTEREGG_100.pcb, EASTEREGG_100.stp]
2021-03-05 erste Erfolge aber auch weiterhin Probleme: Das Ausspielen der Texte über KBD stürzt nach 1..2min ab. TLC Ansteuerung hingegen funktioniert super - erste Animationen und Anzeige BLE CONNECTED über mi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
    [CompLEDs.c, CompLEDs.h, EggLogic.c, EggLogic.h, RC5receiver.c, TLC5955drv.c, app.c]
2021-03-13 angefangen I2C zu integrieren - baut, aber bislang ohne Funktion. Muss auch noch in eigenen Treiber ausgelagert werden. UMSTIEG AUF ONSEMI_IDE_3.4.48
2021-03-19 I2C driver not 100% working so far. Having problems with the GYRO which needs a real REPEATED START - otherwise it resets its internal read pointer back to ZERO. So far I can read the ID register but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
    [GYROdrv.c, GYROdrv.h, PCF8574drv.c, PCF8574drv.h, app.c, app.h, app_init.c, i2c_master.c]
2021-03-20 GYRO funktioniert und zeigt Orientierung auf LED Matrix an
2021-03-22 Rev200 Schaltplan und Layout
    [EASTEREGG_200.pcb]
2021-03-23 es kommen immer noch Phantompulse auf der RC5 Empfangsleitung wenn I2C benutzt wird. RAISE aus dem RC5 Interrupt Handler crasht das ganze System. Daher wird nun gepollt mit "Semaphore". Leider finde 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
    [CompBraille.c, CompLEDs.c, CompLEDs.h, CompMorse.c, EggLogic.c, EggLogic.h, RC5receiver.c, RC5receiver.h]
2021-03-27 HOLY SHITLOAD: wenn ich aus der Statemachine das länger dauernde Senden von Braillecode aufrufe, macht der Prozessor einen Reset. Ich hab schon versucht den Timertick für die Statemachine während der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
    Aber auch dann kann ich nur hoffen, dass das alles dann funktioniert und das Problem nicht woanders liegt.
    ZEFIX! An so einem Scheiss scheitert's d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
    [CompBraille.c, CompLEDs.c, CompLEDs.h, EggLogic.c, TLC5955drv.c]
2021-04-03 neue I2C bitbanging Macros, die nur noch an der DIRECTION und nicht mehr an der Konfiguration der GPIOs rumfummeln. Damit sind die Phantompulse auf der RC5 Eingangsleitung weg. Da hat der RSL10 wohl 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
    [i2c_master.c]
2021-04-06 FUNZT nun ohne Debugger und Abstürze. Die "Magie" ist die Änderung in ble_hogpd.c
2021-04-07 P5APP 1.0.0
    [EASTEREGG_200.pcb]
2021-04-08 P5APP-1.0.2: Braille wird alle 20sec wiederholt bis gedreht wird
2021-04-28 1.0.3: Morse wird alle 30sec wiederholt
2021-04-29 P5APP-1.0.4: Drehhinweis wird nun gemorst, da er kurz ist. Der lange RC5 Hinweis wird in Braille ausgegeben
